OE5XRX/RemoteStation/index.md

---
---

# Amateurfunkclub für Remote Stationen

Diese Seite listet alle Schaltpläne, Platinen und BOMs des Projektes [Remote Station](https://github.com/OE5XRX/RemoteStation) des Vereines [Amateurfunkclub für Remote Stationen](https://oe5xrx.org).

## Bus PCB

<table>
  <tr><th>Top</th><th>Bottom</th></tr>
  <tr>
    <td>top</td>
    <td>bottom</td>
  </tr>
</table>

- [Schaltplan](pcb/bus/bus-schematic.pdf)
- [BOM](pcb/bus/bus-bom.html)
- [iBOM](pcb/bus/bus-ibom.html)
- [JLCPCB fabrication & stencil](pcb/bus/JLCPCB/bus-_JLCPCB_compress.zip)
- [JLCPCB Bom](pcb/bus/JLCPCB/bus_bom_jlc.csv)
- [JLCPCB Pic&Place](pcb/bus/JLCPCB/bus_cpl_jlc.csv)

## Power PCB

<table>
  <tr><th>Top</th><th>Bottom</th></tr>
  <tr>
    <td>top</td>
    <td>bottom</td>
  </tr>
</table>

- [Schaltplan](pcb/power/power-schematic.pdf)
- [BOM](pcb/power/power-bom.html)
- [iBOM](pcb/power/power-ibom.html)
- [JLCPCB fabrication & stencil](pcb/power/JLCPCB/power-_JLCPCB_compress.zip)
- [JLCPCB Bom](pcb/power/JLCPCB/power_bom_jlc.csv)
- [JLCPCB Pic&Place](pcb/power/JLCPCB/power_cpl_jlc.csv)

## CM4 PCB

<table>
  <tr><th>Top</th><th>Bottom</th></tr>
  <tr>
    <td>top</td>
    <td>bottom</td>
  </tr>
</table>

- [Schaltplan](pcb/cm4/cm4-schematic.pdf)
- [BOM](pcb/cm4/cm4-bom.html)
- [iBOM](pcb/cm4/cm4-ibom.html)
- [JLCPCB fabrication & stencil](pcb/cm4/JLCPCB/cm4-_JLCPCB_compress.zip)
- [JLCPCB Bom](pcb/cm4/JLCPCB/cm4_bom_jlc.csv)
- [JLCPCB Pic&Place](pcb/cm4/JLCPCB/cm4_cpl_jlc.csv)

Erstellt am {{ site.time | '%d.%m.%Y %H:%i:%s' }}, mit git hash: {{ site.data['hash'] }}.

**Wir lieben Open Source!**

Open_Source_Initiative
Open-source-hardware-logo
