OE5XRX/RemoteStation/docs/pcb/cm4.md

---
title: CM4 PCB
nav_order: 4
parent: Platinen
---

# CM4 PCB

<table>
  <tr><th>Top</th><th>Bottom</th></tr>
  <tr>
    <td>top</td>
    <td>bottom</td>
  </tr>
</table>

Das `CM4` Modul beherbergt das Gehirn der Remote Station: ein Computer Module 4 (CM4) von Raspberry Pi.
Das CM4 ist eine einfache Platine welche CPU, Speicher, Wifi und andere Komponenten direkt aufgelötet hat. Somit können über die zwei 100pin Stecker alle Schnittstellen direkt angesprochen werden.

**Verwendete Schnittstellen:**

| CM4 Schnittstelle | Anwendung |
| --- | --- |
| I<sup>2</sup>C | Messen der Versorgungsspannungen und Ströme |
| Ethernet | für die Verbindung zum Internet oder andere Netzwerke (Lan, externes Modem, etc.)  |
| SD-Card | für die Software (im Produktiven Betrieb soll das interne eMMC verwendet werden) |
| USB | zum aufspielen eines neuen Images in den eMMC oder zum ansprechen der Bus-Devices  |

Der benötigter Strom für das CM4 ist immer stark Abhängig welche Schnittstellen aktiv sind. Bei einem Raspberry Pi 4 kann dies bis zu 3A betragen. Nachdem jedoch kein HDMI vorgesehen ist wird sich der benötigter Strom auf unter 1A beschränken.

| Spannung | benötigter Strom |
| --- | --- |
| +5V | max. 1A |
| +12V | - |

## Daten

- [Schaltplan](cm4/cm4-schematic.pdf)
- [BOM](cm4/cm4-bom.html)
- [iBOM](cm4/cm4-ibom.html)
- [JLCPCB fabrication & stencil](cm4/JLCPCB/cm4-_JLCPCB_compress.zip)
- [JLCPCB Bom](cm4/JLCPCB/cm4_bom_jlc.csv)
- [JLCPCB Pick&Place](cm4/JLCPCB/cm4_cpl_jlc.csv)

## Gefundene Probleme in v0.1

- [X] Footprint von CM4 passt nicht (Outline muss vergrößert werden), CM4 Modul passt aber aktuell trotzdem drauf. Ausrichtung mit der Antenne beachten dann passt es
- [X] LED Schaltung kontrollieren
- [X] Debug UART (Serielle zur Console) auf Pinheader nach vorne
