OE5XRX/RemoteStation/docs/pcb/bus.md

---
title: Bus PCB
nav_order: 2
parent: Platinen
---

# Bus PCB

<table>
  <tr><th>Top</th><th>Bottom</th></tr>
  <tr>
    <td>top</td>
    <td>bottom</td>
  </tr>
</table>

Die `Bus` Platine verteilt die benötigten Versorgungsspannungen (+5V und +12V) zu allen Modulen. Weiters ist ein USB-Hub auf der Rückseite der Platine vorhanden um dem CM4-Modul Zugriff zu den Devices zu geben.
Die Platine welche die benötigten Versorgungsspannungen zur Verfügung stellt hat auch noch eine I<sup>2</sup>C Bus Verbindung zum CM4-Modul um die Spannungen und Ströme auslesen zu können.

| Spannung | benötigter Strom |
| --- | --- |
| +5V | 100mA |
| +12V | - |

## Daten

- [Schaltplan](bus/bus-schematic.pdf)
- [BOM](bus/bus-bom.html)
- [iBOM](bus/bus-ibom.html)
- [JLCPCB fabrication & stencil](bus/JLCPCB/bus-_JLCPCB_compress.zip)
- [JLCPCB Bom](bus/JLCPCB/bus_bom_jlc.csv)
- [JLCPCB Pick&Place](bus/JLCPCB/bus_cpl_jlc.csv)

## Gefundene Probleme in v0.1

- [X] USBLC6-2SC6 hat falschen Footprint, richtiger ist: SOT-23-6
