OE5XRX/RemoteStation/docs/pcb.md

---
title: Platinen
nav_order: 1
---

# Platinen

In den Unterseite findest du die Dokumentation der Platinen.
