OE5XRX/RemoteStation/pcb/fm/fm.kicad_pcb

## KiCad design pcb/fm/fm.kicad_pcb (2025-07-05)

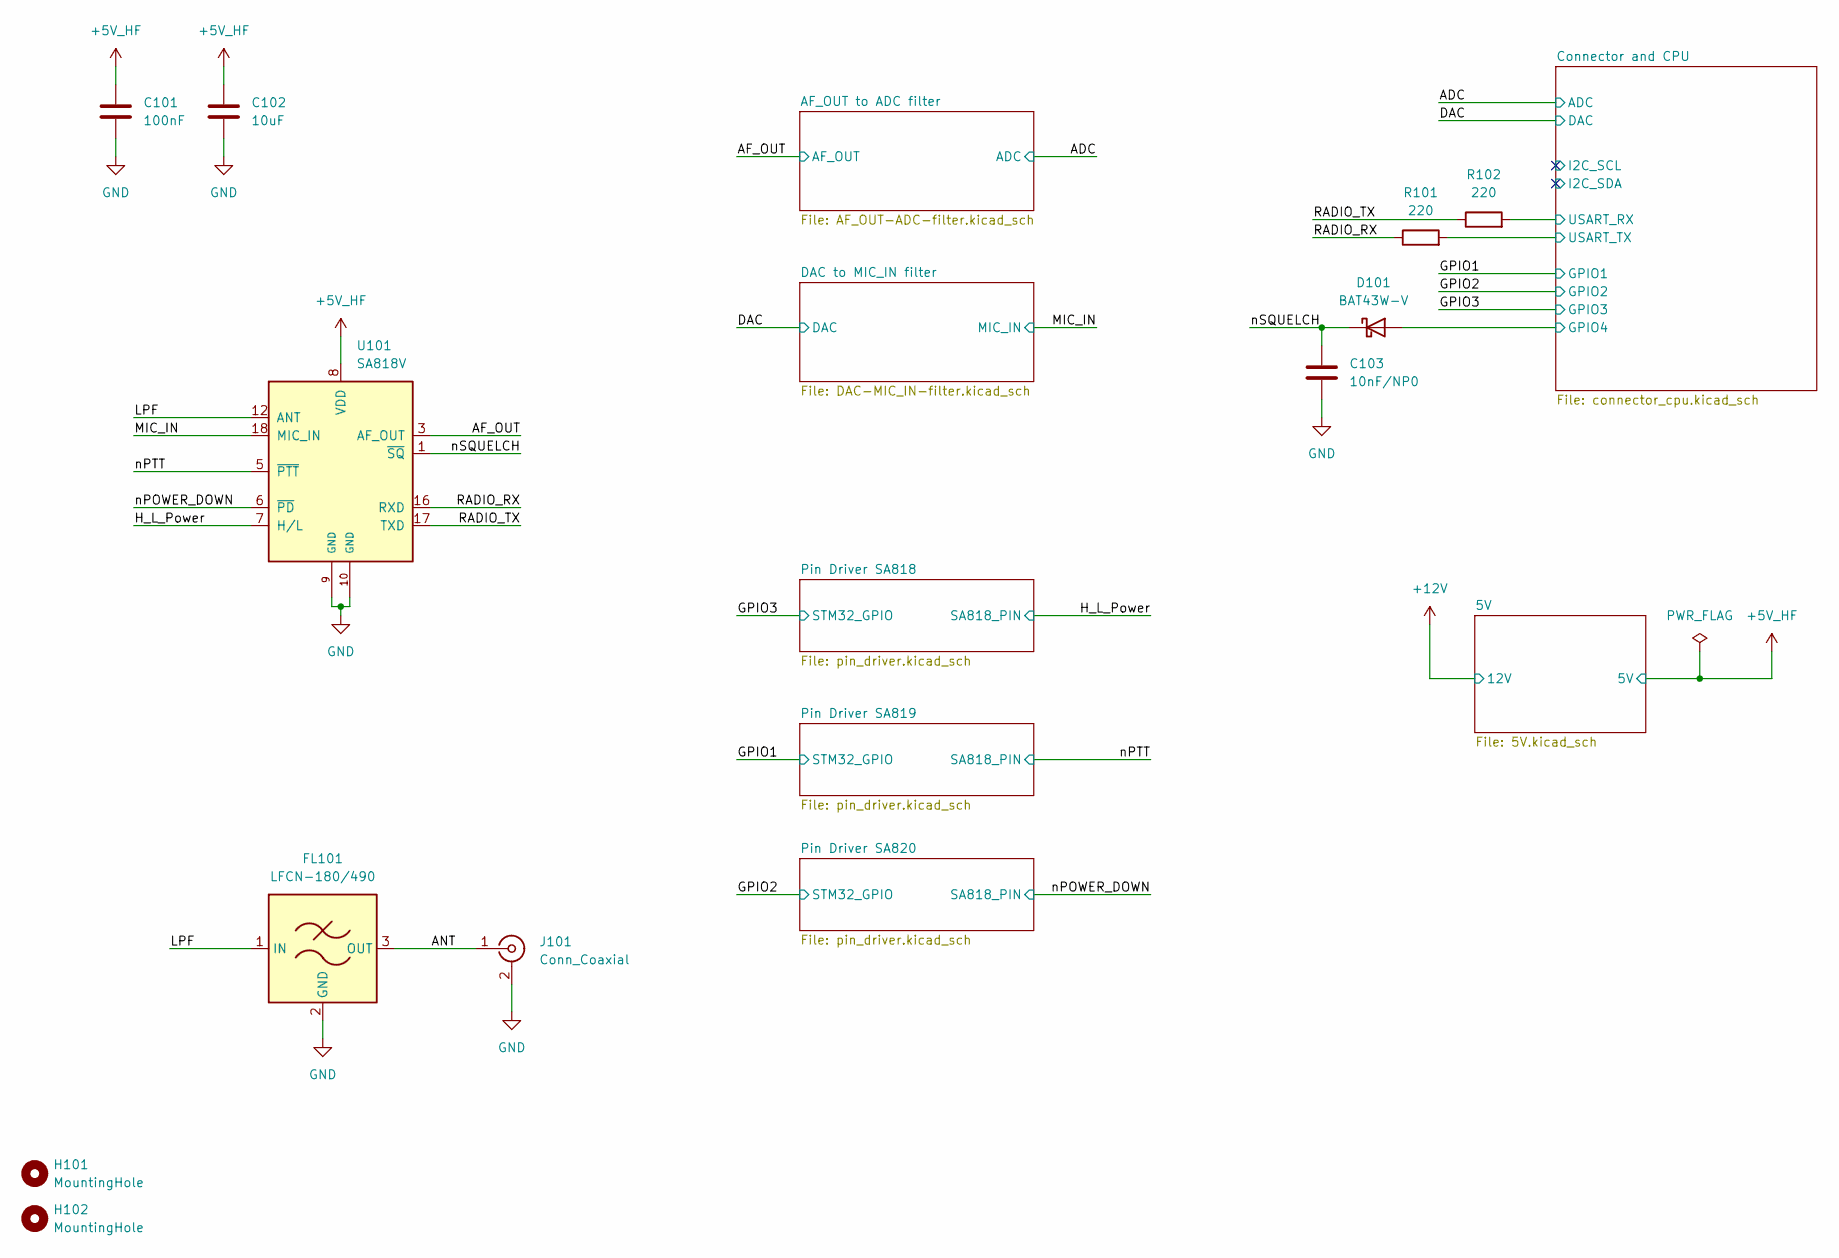
[picture p1: schematic fm.kicad_sch, FM Module]

Parts:
C101: 100nF; C_0805_2012Metric; LCSC C28233
C102: 10uF; C_0805_2012Metric; MOUSER 963-EMK212BJ106KG-T
C103: 10nF/NP0; C_0805_2012Metric; MOUSER 81-GRM2165C2A103JA1D
D101: BAT43W-V; D_SOD-123; MOUSER 78-BAT43W-G3-08
FL101: LFCN-180/490; Filter_Mini-Circuits_FV1206; MOUSER 139-LFCN-180,139-LFCN-490
H101, H102: MountingHole; MountingHole_3.2mm_M3
J101: Conn_Coaxial; SMA_Amphenol_132289_EdgeMount; MOUSER 530-142-0701-801
R101, R102: 220; R_0805_2012Metric; MOUSER 667-ERA-6AEB221V
U101: SA818V; DRA818; LCSC C3001504

Connections:
+5V_HF: C101.2, C102.2, U101.8 (VDD); also elsewhere on the board
/AF_OUT: U101.3 (AF_OUT); also elsewhere on the board
/ANT: FL101.3 (OUT), J101.1 (In)
/Connector and CPU/GPIO4: D101.2 (A); also elsewhere on the board
/Connector and CPU/USART_RX: R102.2; also elsewhere on the board
/Connector and CPU/USART_TX: R101.2; also elsewhere on the board
/H_L_Power: U101.7 (H/L); also elsewhere on the board
/LPF: FL101.1 (IN), U101.12 (ANT)
/MIC_IN: U101.18 (MIC_IN); also elsewhere on the board
/RADIO_RX: R101.1, U101.16 (RXD)
/RADIO_TX: R102.1, U101.17 (TXD)
/nPOWER_DOWN: U101.6 (~PD); also elsewhere on the board
/nPTT: U101.5 (~PTT); also elsewhere on the board
/nSQUELCH: C103.2, D101.1 (K), U101.1 (~SQ)
GND: C101.1, C102.1, C103.1, FL101.2 (GND), FL101.4 (GND), J101.2 (Ext), U101.9 (GND), U101.10 (GND); also elsewhere on the board

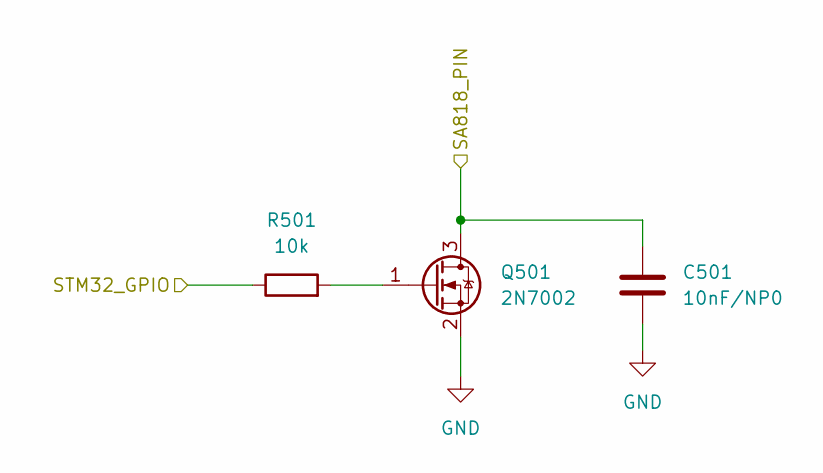
[picture p2: schematic pin_driver.kicad_sch, Pin Driver for the SA818]

Parts:
C501: 10nF/NP0; C_0805_2012Metric; MOUSER 81-GRM2165C2A103JA1D
Q501: 2N7002; SOT-23; MOUSER 637-2N7002
R501: 10k; R_0805_2012Metric; MOUSER 603-RT0805DRE0710KL

Connections:
/GPIO3: R501.1; also elsewhere on the board
/H_L_Power: C501.2, Q501.3 (D); also elsewhere on the board
GND: C501.1, Q501.2 (S); also elsewhere on the board
unnamed: Q501.1 (G), R501.2

Parts of its further copies:
C601, C701: 10nF/NP0; C_0805_2012Metric; MOUSER 81-GRM2165C2A103JA1D
Q601, Q701: 2N7002; SOT-23; MOUSER 637-2N7002
R601, R701: 10k; R_0805_2012Metric; MOUSER 603-RT0805DRE0710KL

Connections of its further copies:
/GPIO1: R601.1; also elsewhere on the board
/GPIO2: R701.1; also elsewhere on the board
/nPOWER_DOWN: C701.2, Q701.3 (D); also elsewhere on the board
/nPTT: C601.2, Q601.3 (D); also elsewhere on the board
GND: C601.1, C701.1, Q601.2 (S), Q701.2 (S); also elsewhere on the board
unnamed: Q601.1 (G), R601.2
unnamed: Q701.1 (G), R701.2

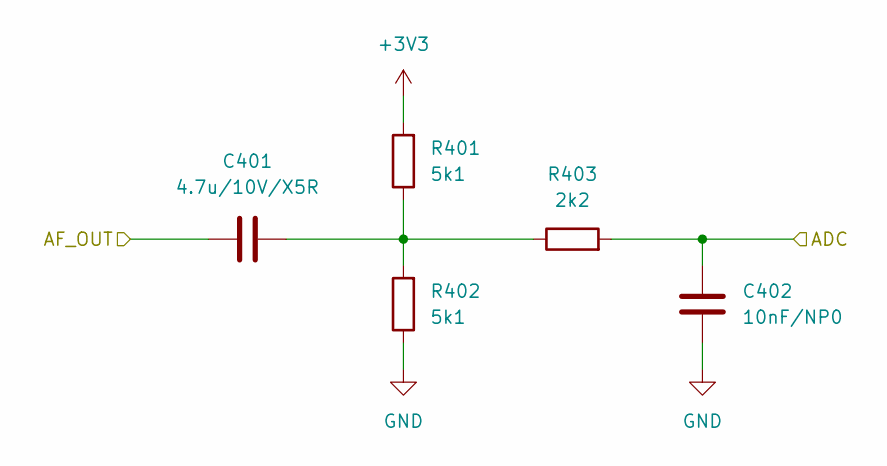
[picture p3: schematic AF_OUT-ADC-filter.kicad_sch, AF_OUT to ADC filter]

Parts:
C401: 4.7u/10V/X5R; C_0805_2012Metric; MOUSER 187-CL21A475KAQNNNF
C402: 10nF/NP0; C_0805_2012Metric; MOUSER 81-GRM2165C2A103JA1D
R401, R402: 5k1; R_0805_2012Metric; LCSC C27834
R403: 2k2; R_0805_2012Metric; LCSC C17520

Connections:
+3V3: R401.2; also elsewhere on the board
/ADC: C402.2, R403.2; also elsewhere on the board
/AF_OUT: C401.2; also elsewhere on the board
GND: C402.1, R402.1; also elsewhere on the board
unnamed: C401.1, R401.1, R402.2, R403.1

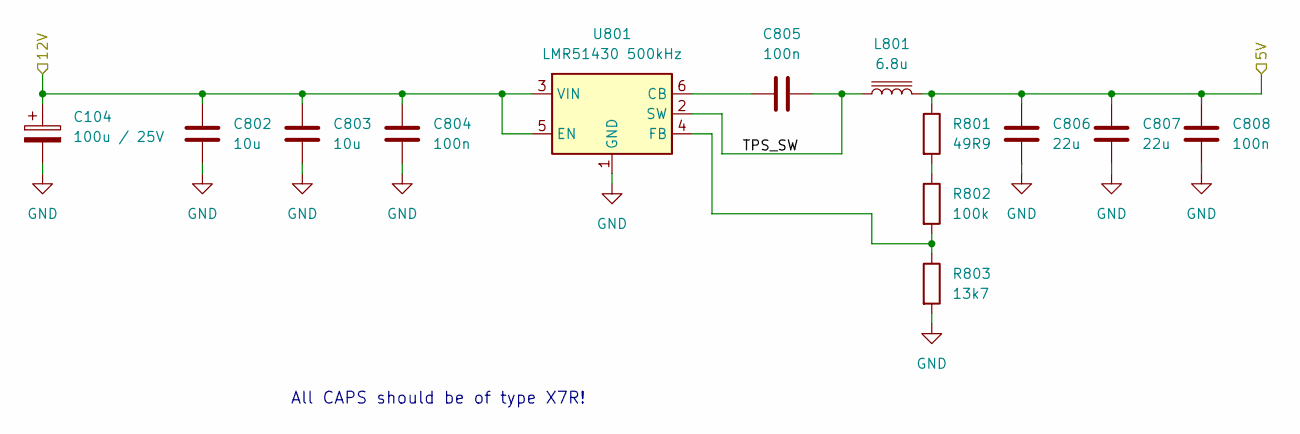
[picture p4: schematic 5V.kicad_sch, 5V HF]

Parts:
C104: 100u / 25V; CP_EIA-7343-43_Kemet-X; LCSC C132558
C802, C803: 10u; C_1206_3216Metric; LCSC C13585
C804, C805, C808: 100n; C_0805_2012Metric; LCSC C28233
C806, C807: 22u; C_1206_3216Metric; LCSC C12891
L801: 6.8u; WE-XHMI_6060; MOUSER 710-74439346068
R801: 49R9; R_0805_2012Metric; MOUSER 667-ERA-6AED49R9V
R802: 100k; R_0805_2012Metric; MOUSER 603-RC0805JR-07100KL
R803: 13k7; R_0805_2012Metric; MOUSER 652-CR0805FX-1372ELF
U801: LMR51430 500kHz; SOT-23-6; MOUSER 595-LMR51430XDDCR

Connections:
+5V_HF: C806.2, C807.2, C808.2, L801.2, R801.1; also elsewhere on the board
+12V: C104.1, C802.1, C803.1, C804.1, U801.3 (VIN), U801.5 (EN); also elsewhere on the board
/5V/TPS_SW: C805.2, L801.1, U801.2 (SW)
GND: C104.2, C802.2, C803.2, C804.2, C806.1, C807.1, C808.1, R803.2, U801.1 (GND); also elsewhere on the board
unnamed: R801.2, R802.1
unnamed: C805.1, U801.6 (CB)
unnamed: R802.2, R803.1, U801.4 (FB)

Notes on the sheet:
All CAPS should be of type X7R!

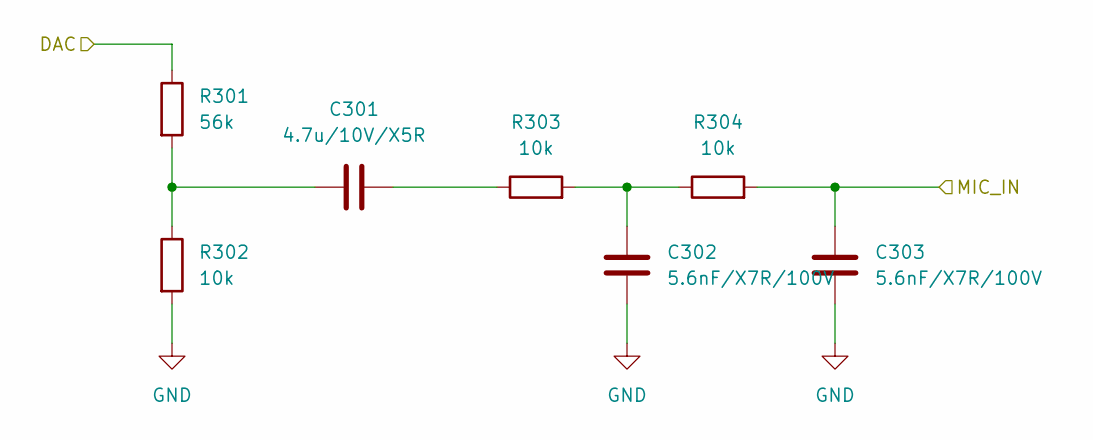
[picture p5: schematic DAC-MIC_IN-filter.kicad_sch, DAC to MIC_IN filter]

Parts:
C301: 4.7u/10V/X5R; C_0805_2012Metric; MOUSER 187-CL21A475KAQNNNF
C302, C303: 5.6nF/X7R/100V; C_0805_2012Metric; MOUSER 791-0805B562K201CT
R301: 56k; R_0805_2012Metric; MOUSER 603-RT0805DRE0756KL
R302, R303, R304: 10k; R_0805_2012Metric; MOUSER 603-RT0805DRE0710KL

Connections:
/DAC: R301.1; also elsewhere on the board
/MIC_IN: C303.1, R304.2; also elsewhere on the board
GND: C302.2, C303.2, R302.2; also elsewhere on the board
unnamed: C301.1, R303.1
unnamed: C301.2, R301.2, R302.1
unnamed: C302.1, R303.2, R304.1

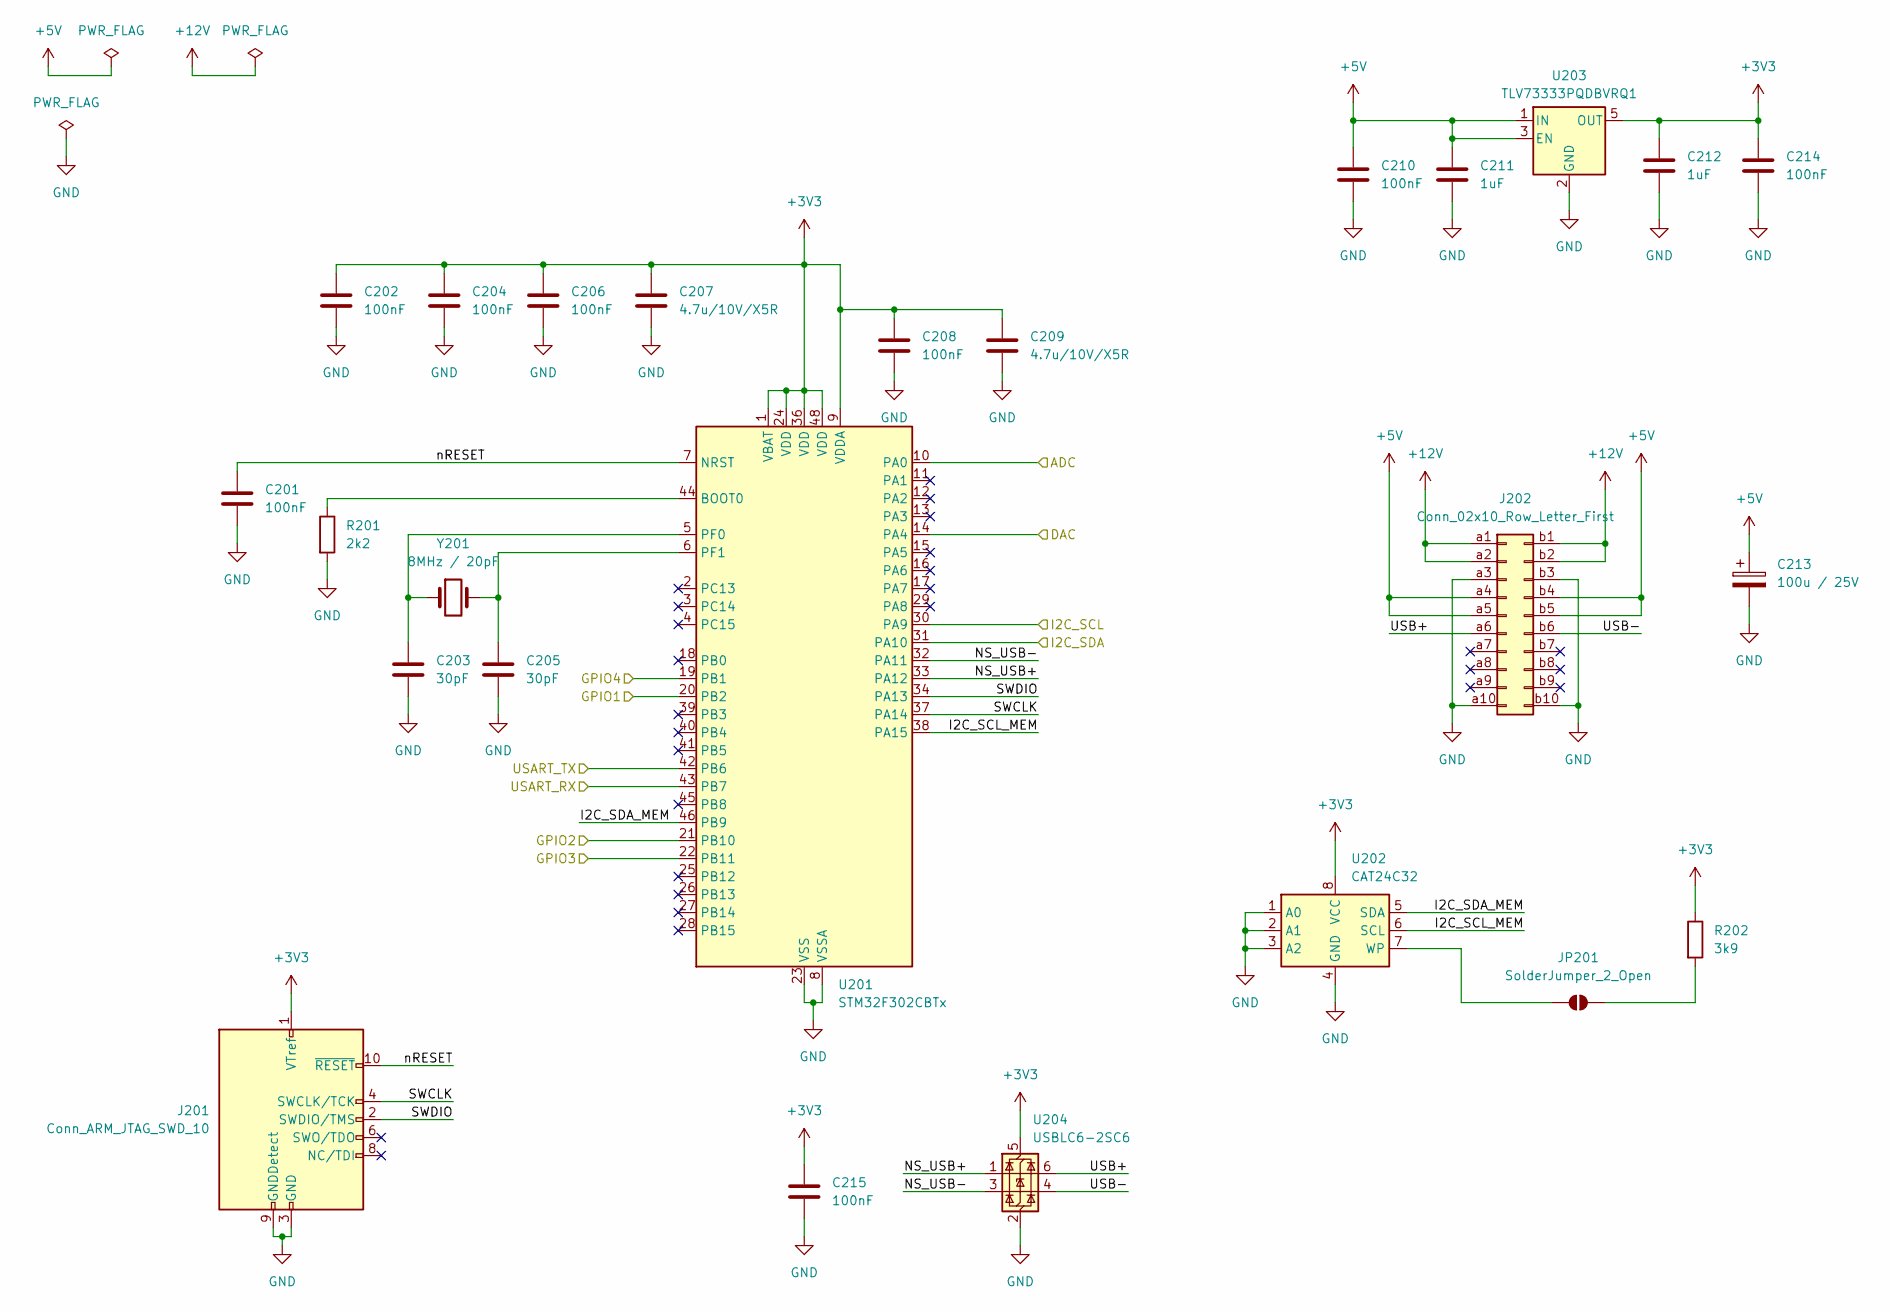
[picture p6: schematic connector_cpu.kicad_sch, STM32]

Parts:
C201, C202, C204, C206, C208, C210, C214, C215: 100nF; C_0805_2012Metric; LCSC C28233
C203, C205: 30pF; C_0805_2012Metric; MOUSER 791-0805N300J500CT
C207, C209: 4.7u/10V/X5R; C_0805_2012Metric; MOUSER 187-CL21A475KAQNNNF
C211, C212: 1uF; C_0805_2012Metric; MOUSER 791-0805B105K250CT
C213: 100u / 25V; CP_EIA-7343-43_Kemet-X; LCSC C132558
J201: Conn_ARM_JTAG_SWD_10; PinHeader_2x05_P2.54mm_Horizontal
J202: Conn_02x10_Row_Letter_First; PCN10C-20S-2.54DS; MOUSER 798-PCN10C20S254DS72
JP201: SolderJumper_2_Open; SolderJumper-2_P1.3mm_Open_RoundedPad1.0x1.5mm
R201: 2k2; R_0805_2012Metric; LCSC C17520
R202: 3k9; R_0805_2012Metric; MOUSER 603-RT0805DRD073K9L
U201: STM32F302CBTx; LQFP-48_7x7mm_P0.5mm; MOUSER 511-STM32F302CBT7
U202: CAT24C32; SOIC-8_3.9x4.9mm_P1.27mm; MOUSER 698-CAT24C32WI-GT3
U203: TLV73333PQDBVRQ1; SOT-23-5; LCSC C2862550
U204: USBLC6-2SC6; SOT-23-6; LCSC C2827654
Y201: 8MHz / 20pF; Crystal_SMD_HC49-SD; MOUSER 73-XT49M800-20

Connections:
+3V3: C202.2, C204.2, C206.2, C207.2, C208.2, C209.2, C212.1, C214.2, C215.1, J201.1 (VTref), R202.1, U201.1 (VBAT), U201.9 (VDDA), U201.24 (VDD), U201.36 (VDD), U201.48 (VDD), U202.8 (VCC), U203.5 (OUT), U204.5 (VBUS); also elsewhere on the board
+5V: C210.2, C211.1, C213.1, J202.a4, J202.a5, J202.b4, J202.b5, U203.1 (IN), U203.3 (EN)
+12V: J202.a1, J202.a2, J202.b1, J202.b2; also elsewhere on the board
/ADC: U201.10 (PA0); also elsewhere on the board
/Connector and CPU/GPIO4: U201.19 (PB1); also elsewhere on the board
/Connector and CPU/I2C_SCL: U201.30 (PA9)
/Connector and CPU/I2C_SCL_MEM: U201.38 (PA15), U202.6 (SCL)
/Connector and CPU/I2C_SDA: U201.31 (PA10)
/Connector and CPU/I2C_SDA_MEM: U201.46 (PB9), U202.5 (SDA)
/Connector and CPU/NS_USB+: U201.33 (PA12), U204.1 (I/O1)
/Connector and CPU/NS_USB-: U201.32 (PA11), U204.3 (I/O2)
/Connector and CPU/SWCLK: J201.4 (SWCLK/TCK), U201.37 (PA14)
/Connector and CPU/SWDIO: J201.2 (SWDIO/TMS), U201.34 (PA13)
/Connector and CPU/USART_RX: U201.43 (PB7); also elsewhere on the board
/Connector and CPU/USART_TX: U201.42 (PB6); also elsewhere on the board
/Connector and CPU/USB+: J202.a6, U204.6 (I/O1)
/Connector and CPU/USB-: J202.b6, U204.4 (I/O2)
/Connector and CPU/nRESET: C201.1, J201.10 (~RESET), U201.7 (NRST)
/DAC: U201.14 (PA4); also elsewhere on the board
/GPIO1: U201.20 (PB2); also elsewhere on the board
/GPIO2: U201.21 (PB10); also elsewhere on the board
/GPIO3: U201.22 (PB11); also elsewhere on the board
GND: C201.2, C202.1, C203.2, C204.1, C205.2, C206.1, C207.1, C208.1, C209.1, C210.1, C211.2, C212.2, C213.2, C214.1, C215.2, J201.3 (GND), J201.5 (GND), J201.9 (GNDDetect), J202.a3, J202.a10, J202.b3, J202.b10, R201.2, U201.8 (VSSA), U201.23 (VSS), U201.35 (VSS), U201.47 (VSS), U202.1 (A0), U202.2 (A1), U202.3 (A2), U202.4 (GND), U203.2 (GND), U204.2 (GND); also elsewhere on the board
unnamed: JP201.1 (A), U202.7 (WP)
unnamed: JP201.2 (B), R202.2
unnamed: R201.1, U201.44 (BOOT0)
unnamed: C203.1, U201.5 (PF0), Y201.1
unnamed: C205.1, U201.6 (PF1), Y201.2

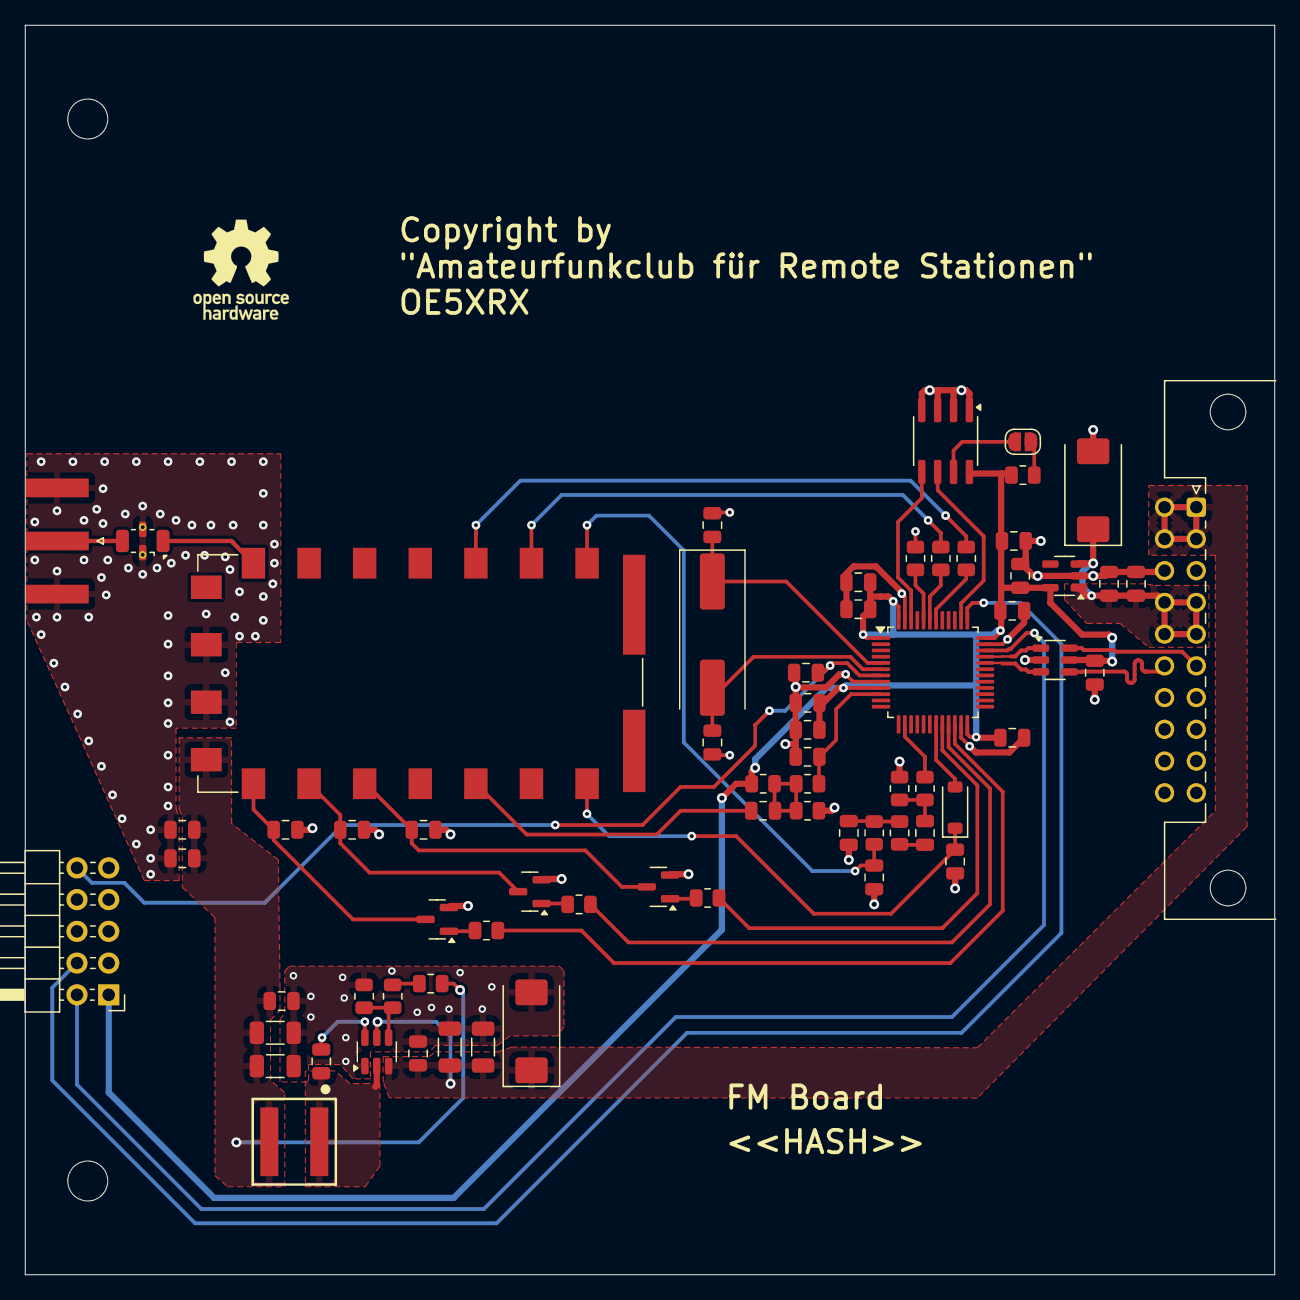
[picture p7: board fm.kicad_pcb from above]

Board: 4 copper layers, 100.0 x 100.0 mm, 70 parts (0 on the bottom side), 48 nets.
