OE5XRX/RemoteStation/pcb/bus/bus.kicad_pcb

## KiCad design pcb/bus/bus.kicad_pcb (2025-07-01)

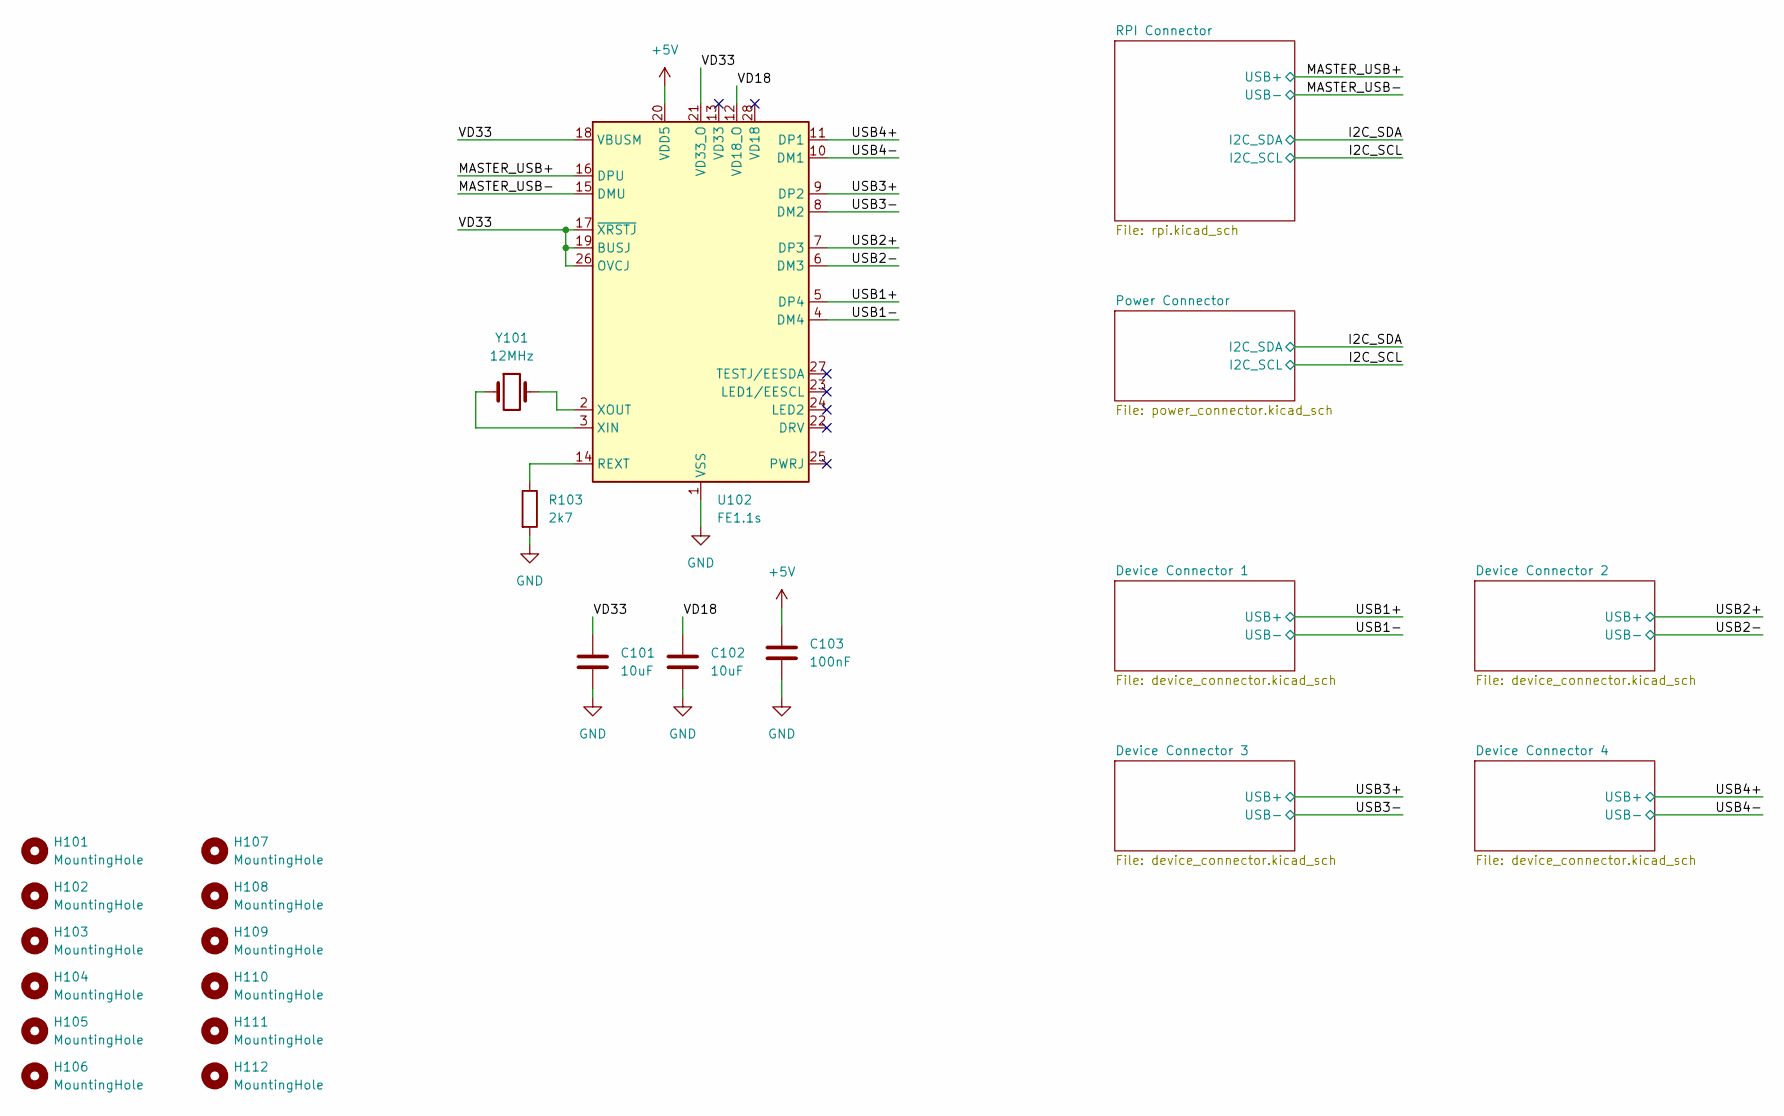
[picture p8: schematic bus.kicad_sch, Bus, USB]

Parts:
C101, C102: 10uF; C_0805_2012Metric; LCSC C13585
C103: 100nF; C_0805_2012Metric; LCSC C28233
H101, H102, H103, H104, H105, H106, H107, H108, H109, H110, H111, H112: MountingHole; MountingHole_3.2mm_M3
R103: 2k7; R_0805_2012Metric; LCSC C352230
U102: FE1.1s; SSOP-28_3.9x9.9mm_P0.635mm; LCSC C6706491
Y101: 12MHz; M49S-SMD; LCSC C2983432

Connections:
+5V: C103.1, U102.20 (VDD5); also elsewhere on the board
/MASTER_USB+: U102.16 (DPU); also elsewhere on the board
/MASTER_USB-: U102.15 (DMU); also elsewhere on the board
/USB1+: U102.5 (DP4); also elsewhere on the board
/USB1-: U102.4 (DM4); also elsewhere on the board
/USB2+: U102.7 (DP3); also elsewhere on the board
/USB2-: U102.6 (DM3); also elsewhere on the board
/USB3+: U102.9 (DP2); also elsewhere on the board
/USB3-: U102.8 (DM2); also elsewhere on the board
/USB4+: U102.11 (DP1); also elsewhere on the board
/USB4-: U102.10 (DM1); also elsewhere on the board
/VD18: C102.1, U102.12 (VD18_O)
/VD33: C101.1, U102.17 (~XRSTJ), U102.18 (VBUSM), U102.19 (BUSJ), U102.21 (VD33_O), U102.26 (OVCJ)
GND: C101.2, C102.2, C103.2, R103.2, U102.1 (VSS); also elsewhere on the board
unnamed: R103.1, U102.14 (REXT)
unnamed: U102.3 (XIN), Y101.1
unnamed: U102.2 (XOUT), Y101.2

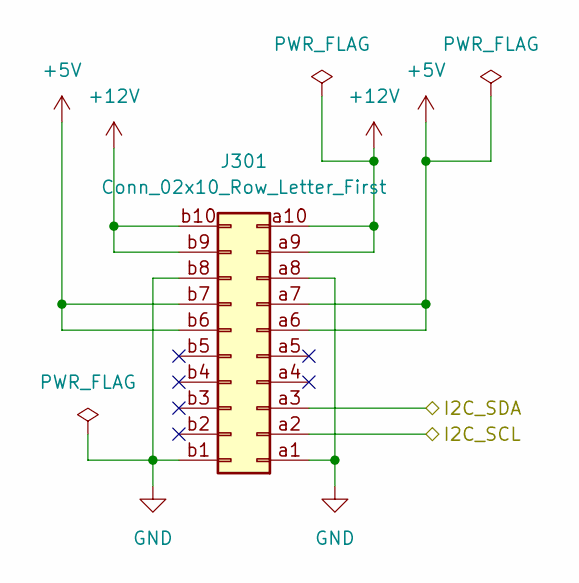
[picture p9: schematic power_connector.kicad_sch]

Parts:
J301: Conn_02x10_Row_Letter_First; PCN10-20P-2.54DSA; MOUSER 798-PCN1020P254DSA72

Connections:
+5V: J301.a6, J301.a7, J301.b6, J301.b7; also elsewhere on the board
+12V: J301.a9, J301.a10, J301.b9, J301.b10; also elsewhere on the board
/I2C_SCL: J301.a2; also elsewhere on the board
/I2C_SDA: J301.a3; also elsewhere on the board
GND: J301.a1, J301.a8, J301.b1, J301.b8; also elsewhere on the board

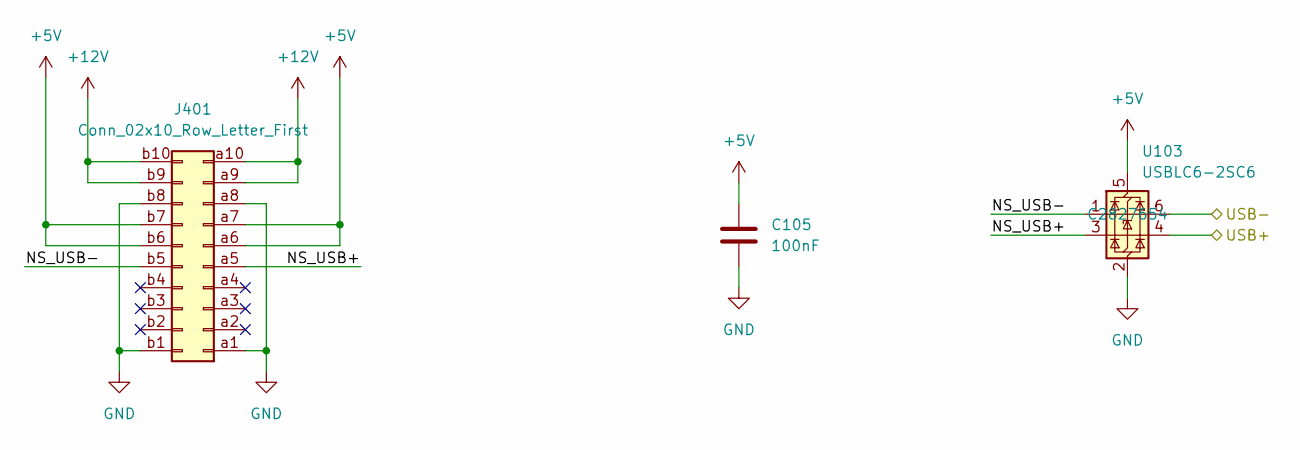
[picture p10: schematic device_connector.kicad_sch]

Parts:
C105: 100nF; C_0805_2012Metric; LCSC C28233
J401: Conn_02x10_Row_Letter_First; PCN10-20P-2.54DSA; MOUSER 798-PCN1020P254DSA72
U103: USBLC6-2SC6; SOT-23-6; LCSC C2827654

Connections:
+5V: C105.1, J401.a6, J401.a7, J401.b6, J401.b7, U103.5 (VBUS); also elsewhere on the board
+12V: J401.a9, J401.a10, J401.b9, J401.b10; also elsewhere on the board
/Device Connector 1/NS_USB+: J401.a5, U103.3 (I/O2)
/Device Connector 1/NS_USB-: J401.b5, U103.1 (I/O1)
/USB1+: U103.4 (I/O2); also elsewhere on the board
/USB1-: U103.6 (I/O1); also elsewhere on the board
GND: C105.2, J401.a1, J401.a8, J401.b1, J401.b8, U103.2 (GND); also elsewhere on the board

Parts of its further copies:
C106, C107, C108: 100nF; C_0805_2012Metric; LCSC C28233
J501, J601, J701: Conn_02x10_Row_Letter_First; PCN10-20P-2.54DSA; MOUSER 798-PCN1020P254DSA72
U104, U105, U106: USBLC6-2SC6; SOT-23-6; LCSC C2827654

Connections of its further copies:
+5V: C106.1, C107.1, C108.1, J501.a6, J501.a7, J501.b6, J501.b7, J601.a6, J601.a7, J601.b6, J601.b7, J701.a6, J701.a7, J701.b6, J701.b7, U104.5 (VBUS), U105.5 (VBUS), U106.5 (VBUS); also elsewhere on the board
+12V: J501.a9, J501.a10, J501.b9, J501.b10, J601.a9, J601.a10, J601.b9, J601.b10, J701.a9, J701.a10, J701.b9, J701.b10; also elsewhere on the board
/Device Connector 2/NS_USB+: J501.a5, U104.3 (I/O2)
/Device Connector 2/NS_USB-: J501.b5, U104.1 (I/O1)
/Device Connector 3/NS_USB+: J601.a5, U105.3 (I/O2)
/Device Connector 3/NS_USB-: J601.b5, U105.1 (I/O1)
/Device Connector 4/NS_USB+: J701.a5, U106.3 (I/O2)
/Device Connector 4/NS_USB-: J701.b5, U106.1 (I/O1)
/USB2+: U104.4 (I/O2); also elsewhere on the board
/USB2-: U104.6 (I/O1); also elsewhere on the board
/USB3+: U105.4 (I/O2); also elsewhere on the board
/USB3-: U105.6 (I/O1); also elsewhere on the board
/USB4+: U106.4 (I/O2); also elsewhere on the board
/USB4-: U106.6 (I/O1); also elsewhere on the board
GND: C106.2, C107.2, C108.2, J501.a1, J501.a8, J501.b1, J501.b8, J601.a1, J601.a8, J601.b1, J601.b8, J701.a1, J701.a8, J701.b1, J701.b8, U104.2 (GND), U105.2 (GND), U106.2 (GND); also elsewhere on the board

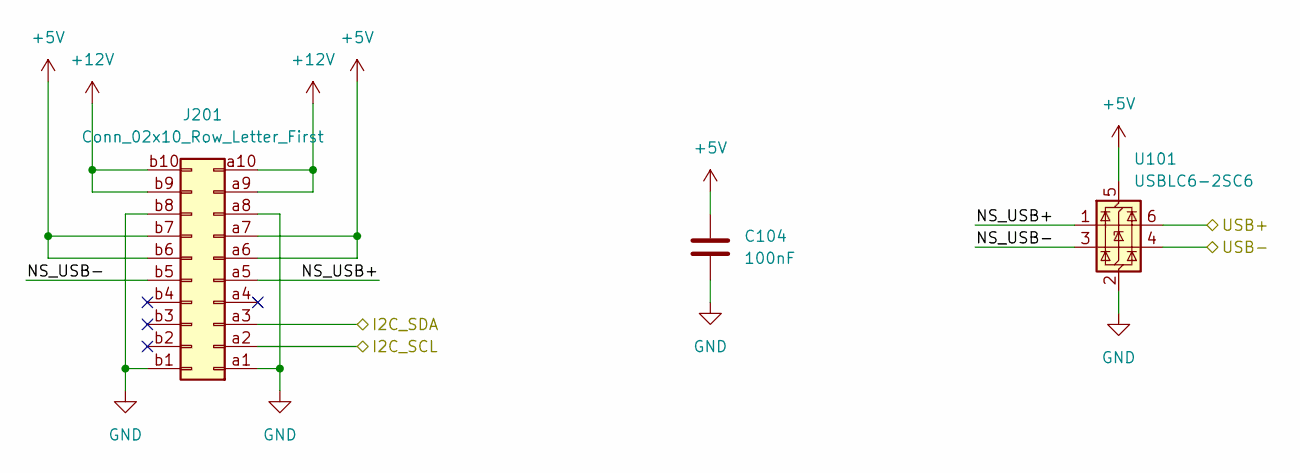
[picture p11: schematic rpi.kicad_sch, Bus Connector]

Parts:
C104: 100nF; C_0805_2012Metric; LCSC C28233
J201: Conn_02x10_Row_Letter_First; PCN10-20P-2.54DSA; MOUSER 798-PCN1020P254DSA72
U101: USBLC6-2SC6; SOT-23-6; LCSC C2827654

Connections:
+5V: C104.1, J201.a6, J201.a7, J201.b6, J201.b7, U101.5 (VBUS); also elsewhere on the board
+12V: J201.a9, J201.a10, J201.b9, J201.b10; also elsewhere on the board
/I2C_SCL: J201.a2; also elsewhere on the board
/I2C_SDA: J201.a3; also elsewhere on the board
/MASTER_USB+: U101.6 (I/O1); also elsewhere on the board
/MASTER_USB-: U101.4 (I/O2); also elsewhere on the board
/RPI Connector/NS_USB+: J201.a5, U101.1 (I/O1)
/RPI Connector/NS_USB-: J201.b5, U101.3 (I/O2)
GND: C104.2, J201.a1, J201.a8, J201.b1, J201.b8, U101.2 (GND); also elsewhere on the board

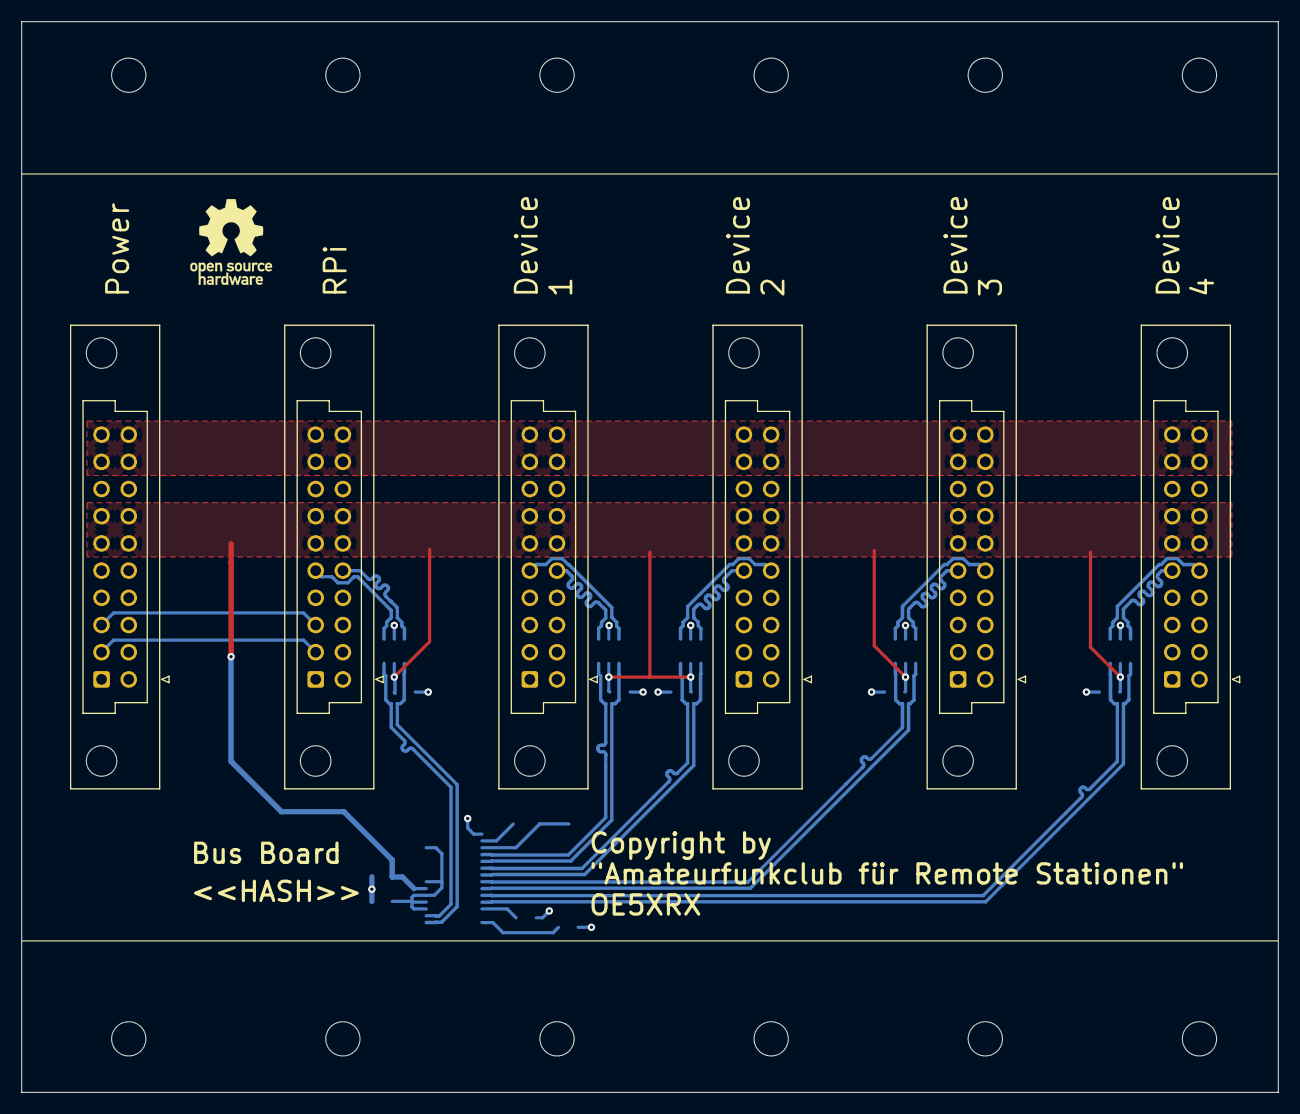
[picture p12: board bus.kicad_pcb from above]

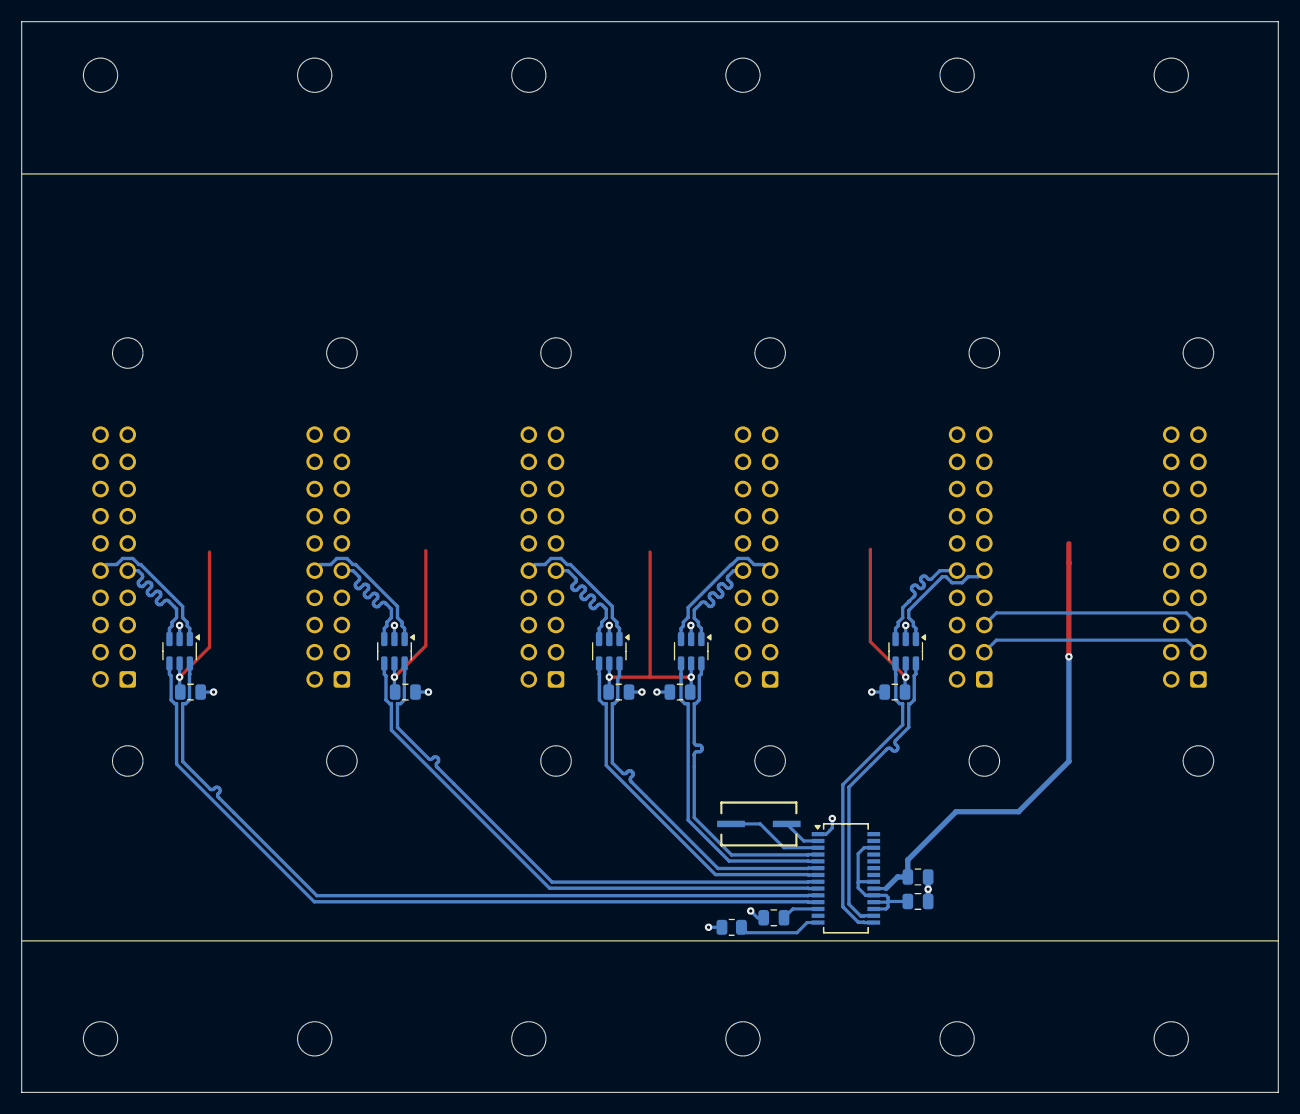
[picture p13: board bus.kicad_pcb from below]

Board: 4 copper layers, 117.4 x 100.0 mm, 34 parts (16 on the bottom side), 30 nets.
