OE5XRX/RemoteStation/pcb/device_test/device_test.kicad_pcb

## KiCad design pcb/device_test/device_test.kicad_pcb (2025-05-25)

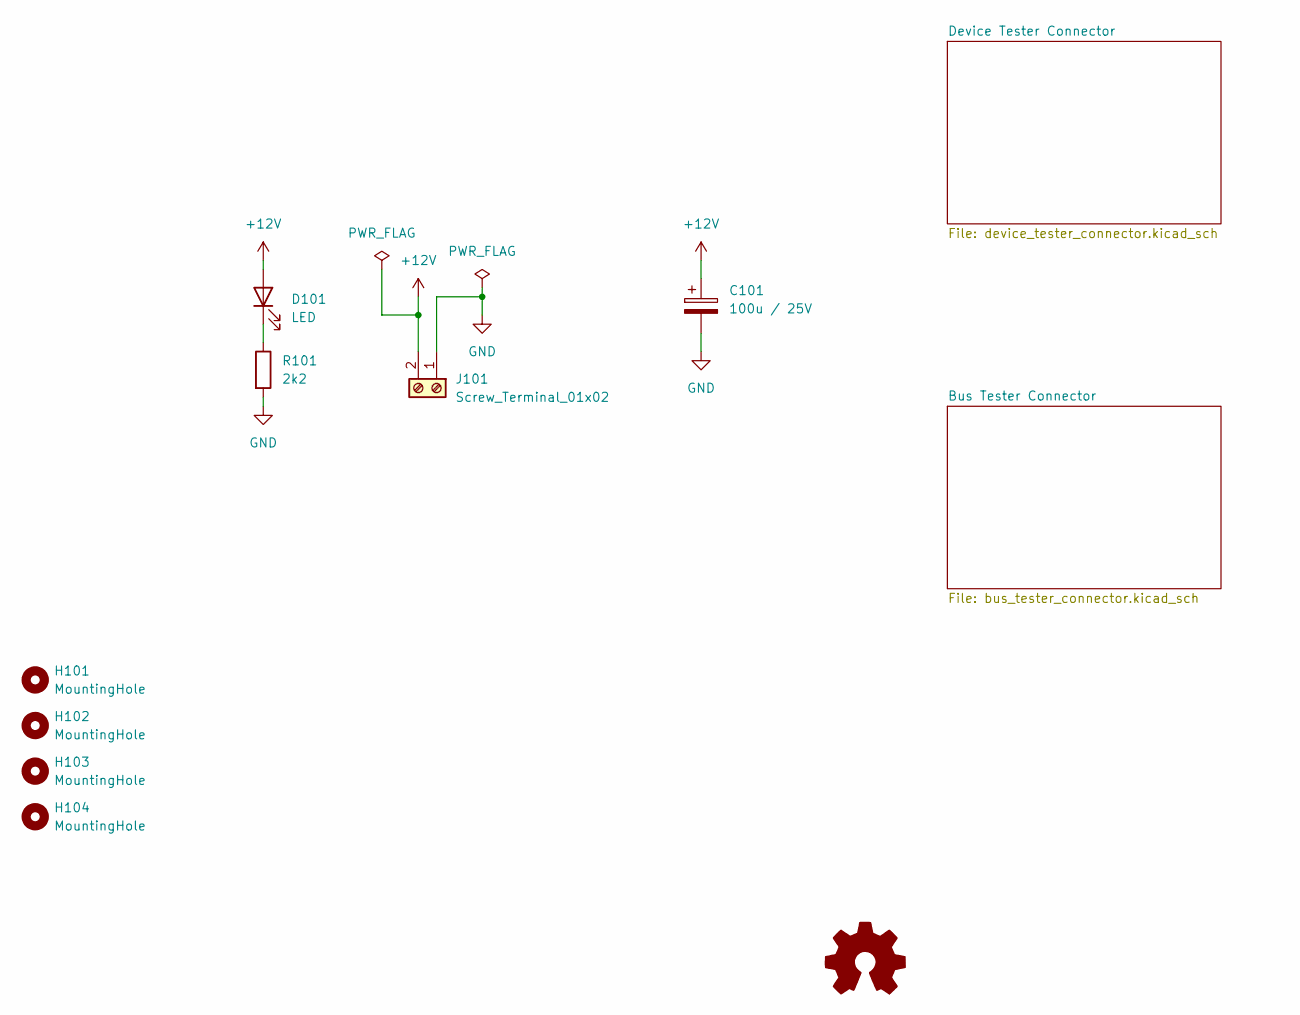
[picture p14: schematic device_test.kicad_sch, Device Tester]

Parts:
C101: 100u / 25V; CP_EIA-7343-43_Kemet-X; LCSC C132558
D101: LED; LED_0805_2012Metric; LCSC C84256
H101, H102, H103, H104: MountingHole; MountingHole_3.2mm_M3
J101: Screw_Terminal_01x02; TerminalBlock_Phoenix_MKDS-1,5-2-5.08_1x02_P5.08mm_Horizont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; LCSC C5349557
R101: 2k2; R_0805_2012Metric; LCSC C17520

Connections:
+12V: C101.1, D101.2 (A), J101.2; also elsewhere on the board
GND: C101.2, J101.1, R101.2; also elsewhere on the board
unnamed: D101.1 (K), R101.1

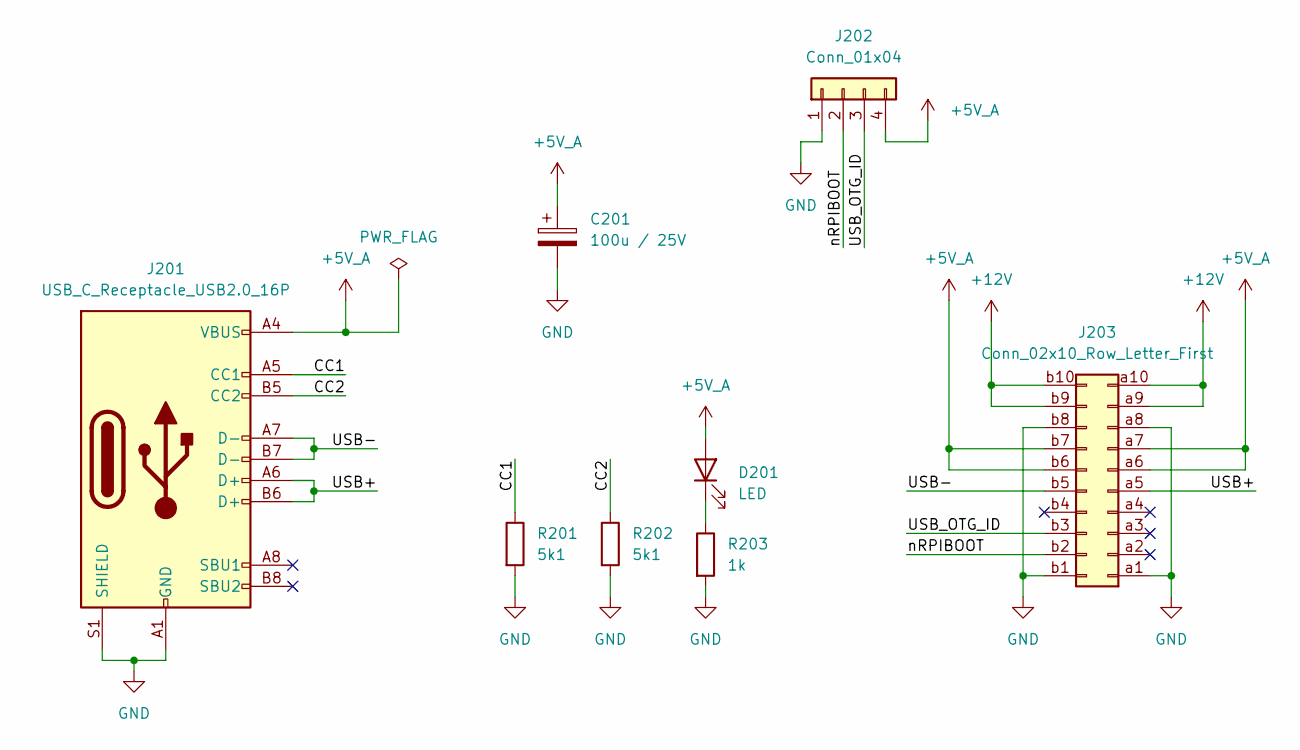
[picture p15: schematic device_tester_connector.kicad_sch, Device Tester Connector]

Parts:
C201: 100u / 25V; CP_EIA-7343-43_Kemet-X; LCSC C132558
D201: LED; LED_0805_2012Metric; LCSC C84256
J201: USB_C_Receptacle_USB2.0_16P; USB_C_Receptacle_G-Switch_GT-USB-7010ASV; LCSC C2988369
J202: Conn_01x04; PinHeader_1x04_P2.54mm_Vertical; LCSC C2691448
J203: Conn_02x10_Row_Letter_First; PCN10-20P-2.54DS; MOUSER 798-PCN1020P254DS72
R201, R202: 5k1; R_0805_2012Metric; LCSC C27834
R203: 1k; R_0805_2012Metric; LCSC C17513

Connections:
+5V_A: C201.1, D201.2 (A), J201.A4 (VBUS), J201.A9 (VBUS), J201.B4 (VBUS), J201.B9 (VBUS), J202.4, J203.a6, J203.a7, J203.b6, J203.b7
+12V: J203.a9, J203.a10, J203.b9, J203.b10; also elsewhere on the board
/Device Tester Connector/CC1: J201.A5 (CC1), R201.1
/Device Tester Connector/CC2: J201.B5 (CC2), R202.1
/Device Tester Connector/USB+: J201.A6 (D+), J201.B6 (D+), J203.a5
/Device Tester Connector/USB-: J201.A7 (D-), J201.B7 (D-), J203.b5
/Device Tester Connector/USB_OTG_ID: J202.3, J203.b3
/Device Tester Connector/nRPIBOOT: J202.2, J203.b2
GND: C201.2, J201.A1 (GND), J201.A12 (GND), J201.B1 (GND), J201.B12 (GND), J201.S1 (SHIELD), J202.1, J203.a1, J203.a8, J203.b1, J203.b8, R201.2, R202.2, R203.2; also elsewhere on the board
unnamed: D201.1 (K), R203.1

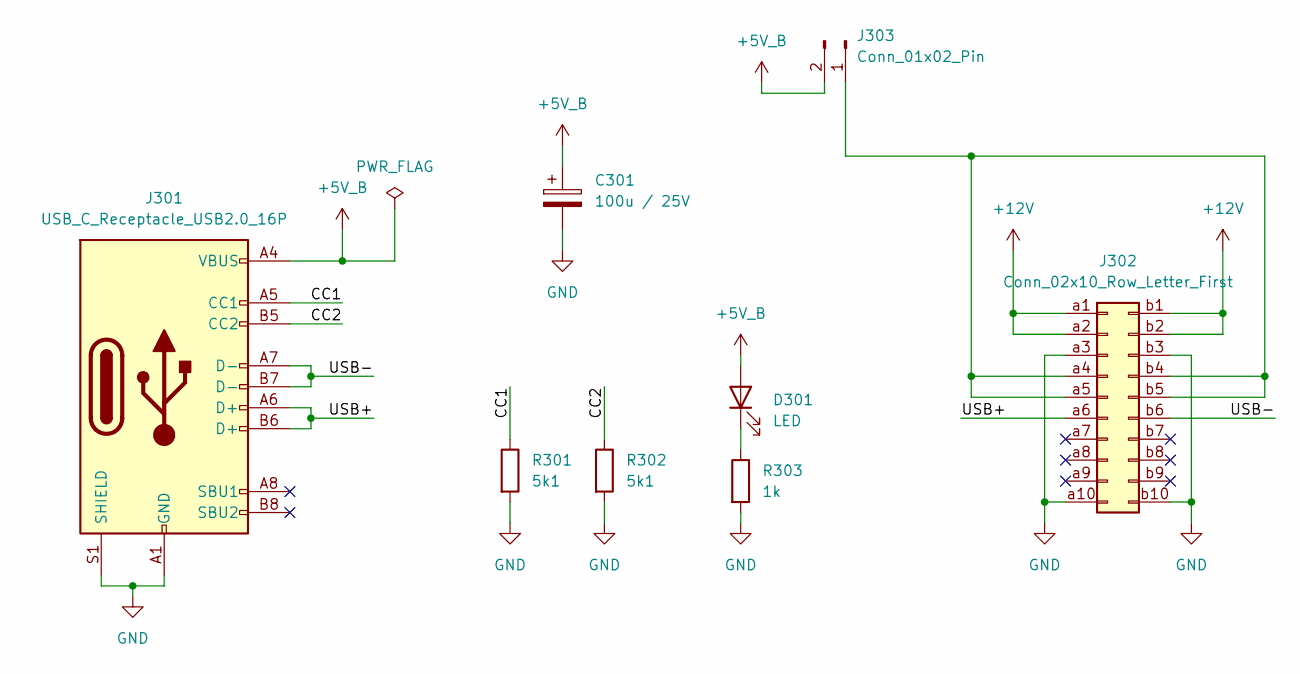
[picture p16: schematic bus_tester_connector.kicad_sch, Device Tester Connector]

Parts:
C301: 100u / 25V; CP_EIA-7343-43_Kemet-X; LCSC C132558
D301: LED; LED_0805_2012Metric; LCSC C84256
J301: USB_C_Receptacle_USB2.0_16P; USB_C_Receptacle_G-Switch_GT-USB-7010ASV; LCSC C2988369
J302: Conn_02x10_Row_Letter_First; PCN10C-20S-2.54DS; MOUSER 798-PCN10C20S254DS72
J303: Conn_01x02_Pin; PinHeader_1x02_P2.54mm_Vertical
R301, R302: 5k1; R_0805_2012Metric; LCSC C27834
R303: 1k; R_0805_2012Metric; LCSC C17513

Connections:
+5V_B: C301.1, D301.2 (A), J301.A4 (VBUS), J301.A9 (VBUS), J301.B4 (VBUS), J301.B9 (VBUS), J303.2
+12V: J302.a1, J302.a2, J302.b1, J302.b2; also elsewhere on the board
/Bus Tester Connector/CC1: J301.A5 (CC1), R301.1
/Bus Tester Connector/CC2: J301.B5 (CC2), R302.1
/Bus Tester Connector/USB+: J301.A6 (D+), J301.B6 (D+), J302.a6
/Bus Tester Connector/USB-: J301.A7 (D-), J301.B7 (D-), J302.b6
GND: C301.2, J301.A1 (GND), J301.A12 (GND), J301.B1 (GND), J301.B12 (GND), J301.S1 (SHIELD), J302.a3, J302.a10, J302.b3, J302.b10, R301.2, R302.2, R303.2; also elsewhere on the board
unnamed: D301.1 (K), R303.1
unnamed: J302.a4, J302.a5, J302.b4, J302.b5, J303.1

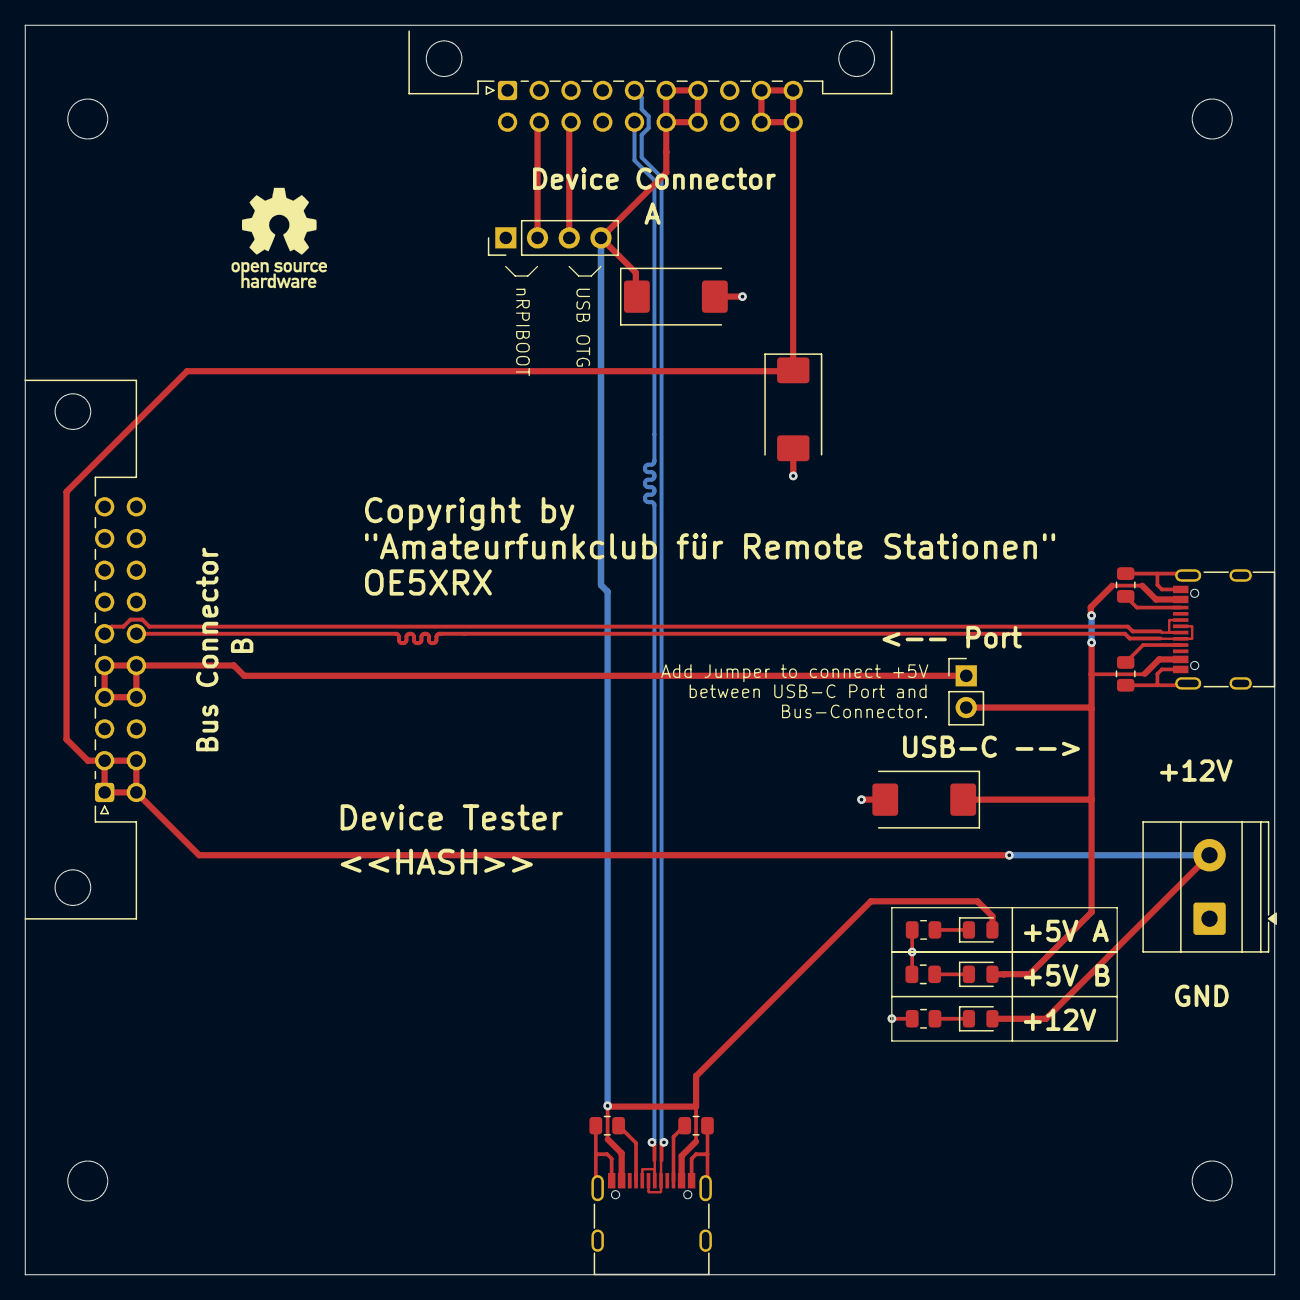
[picture p17: board device_test.kicad_pcb from above]

Board: 4 copper layers, 100.0 x 100.0 mm, 24 parts (0 on the bottom side), 18 nets.
