OE5XRX/RemoteStation/pcb/cm4/cm4.kicad_pcb

## KiCad design pcb/cm4/cm4.kicad_pcb (2025-05-25)

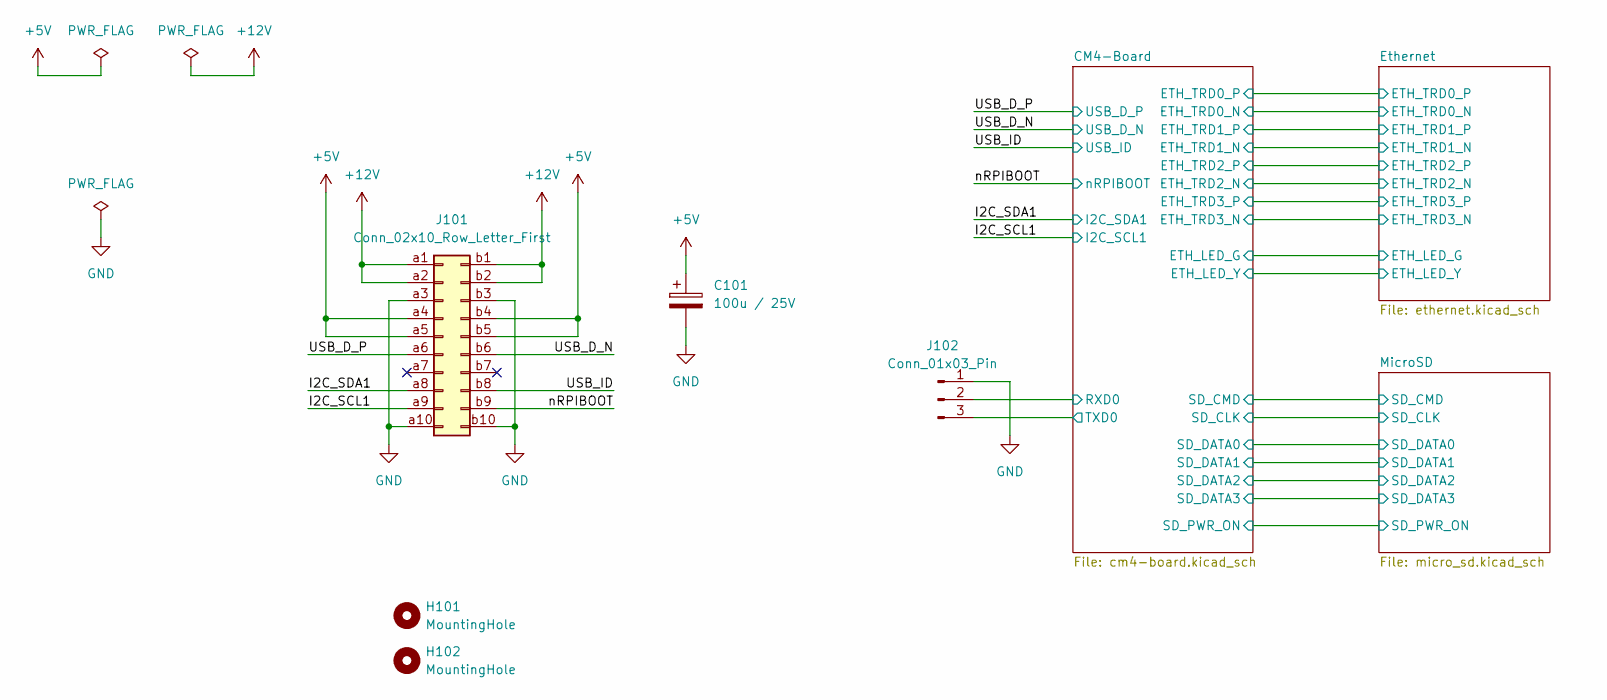
[picture p18: schematic cm4.kicad_sch, Bus Connector]

Parts:
C101: 100u / 25V; CP_EIA-7343-43_Kemet-X; LCSC C132558
H101, H102: MountingHole; MountingHole_3.2mm_M3
J101: Conn_02x10_Row_Letter_First; PCN10C-20S-2.54DS; MOUSER 798-PCN10C20S254DS72
J102: Conn_01x03_Pin; PinHeader_1x03_P2.54mm_Horizontal

Connections:
+5V: C101.1, J101.a4, J101.a5, J101.b4, J101.b5; also elsewhere on the board
+12V: J101.a1, J101.a2, J101.b1, J101.b2
/CM4-Board/RXD0: J102.2; also elsewhere on the board
/CM4-Board/TXD0: J102.3; also elsewhere on the board
/I2C_SCL1: J101.a9; also elsewhere on the board
/I2C_SDA1: J101.a8; also elsewhere on the board
/USB_D_N: J101.b6; also elsewhere on the board
/USB_D_P: J101.a6; also elsewhere on the board
/USB_ID: J101.b8; also elsewhere on the board
/nRPIBOOT: J101.b9; also elsewhere on the board
GND: C101.2, J101.a3, J101.a10, J101.b3, J101.b10, J102.1; also elsewhere on the board

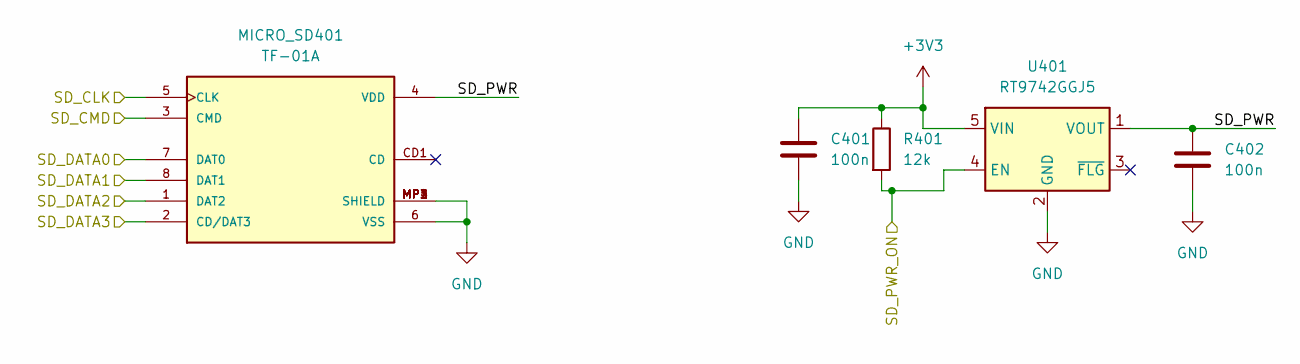
[picture p19: schematic micro_sd.kicad_sch, MicroSD Slot for CM4 (just for debugging!)]

Parts:
C401, C402: 100n; C_0805_2012Metric; LCSC C28233
MICRO_SD401: TF-01A; LCSC C91145
R401: 12k; R_0805_2012Metric; LCSC C17444
U401: RT9742GGJ5; TSOT-23-5; LCSC C250547

Connections:
+3V3: C401.1, R401.1, U401.5 (VIN); also elsewhere on the board
/CM4-Board/SD_CLK: MICRO_SD401.5 (CLK); also elsewhere on the board
/CM4-Board/SD_CMD: MICRO_SD401.3 (CMD); also elsewhere on the board
/CM4-Board/SD_DATA0: MICRO_SD401.7 (DAT0); also elsewhere on the board
/CM4-Board/SD_DATA1: MICRO_SD401.8 (DAT1); also elsewhere on the board
/CM4-Board/SD_DATA2: MICRO_SD401.1 (DAT2); also elsewhere on the board
/CM4-Board/SD_DATA3: MICRO_SD401.2 (CD/DAT3); also elsewhere on the board
/CM4-Board/SD_PWR_ON: R401.2, U401.4 (EN); also elsewhere on the board
/MicroSD/SD_PWR: C402.1, MICRO_SD401.4 (VDD), U401.1 (VOUT)
GND: C401.2, C402.2, MICRO_SD401.6 (VSS), MICRO_SD401.MP1 (SHIELD), MICRO_SD401.MP2 (SHIELD), MICRO_SD401.MP3 (SHIELD), MICRO_SD401.MP4 (SHIELD), U401.2 (GND); also elsewhere on the board

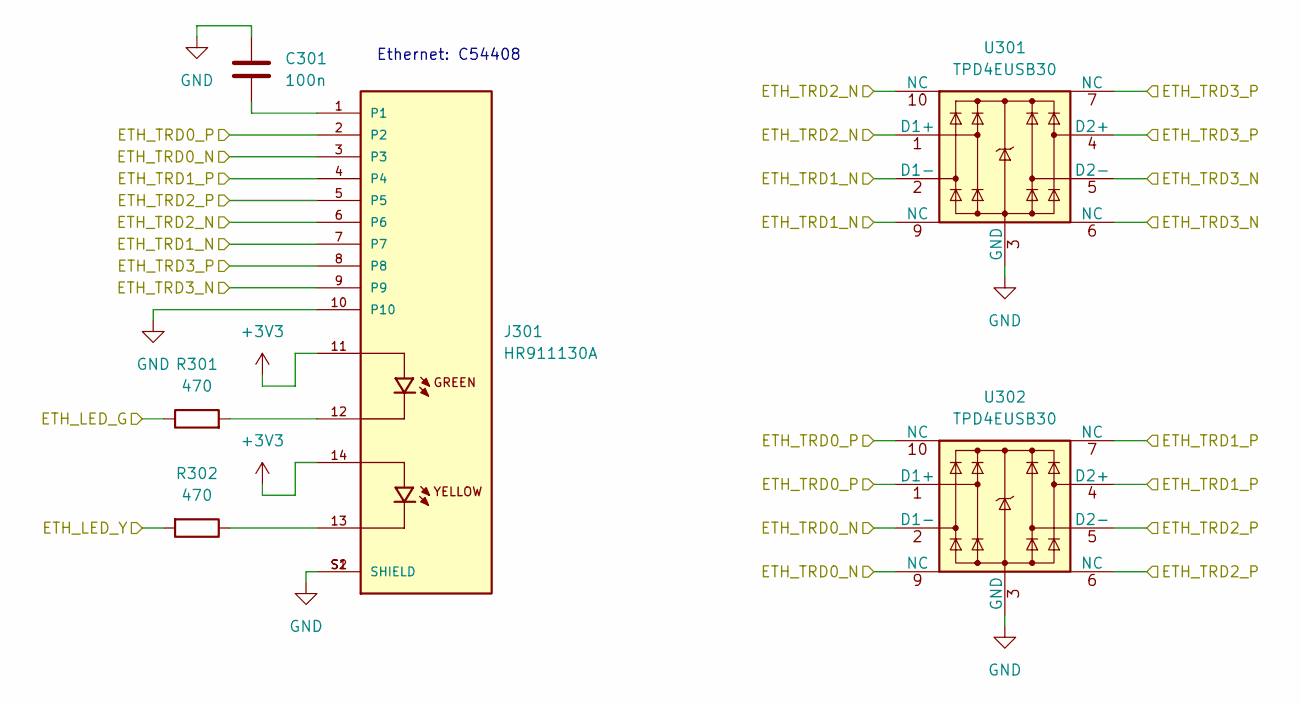
[picture p20: schematic ethernet.kicad_sch, Ethernet Port for CM4]

Parts:
C301: 100n; C_0805_2012Metric; LCSC C28233
J301: HR911130A; HANRUN_HR911130A; PARTREV A; LCSC C54408
R301, R302: 470; R_0805_2012Metric; LCSC C17710
U301, U302: TPD4EUSB30; USON-10_2.5x1.0mm_P0.5mm; LCSC C90627

Connections:
+3V3: J301.11, J301.14; also elsewhere on the board
/CM4-Board/ETH_LED_G: R301.1; also elsewhere on the board
/CM4-Board/ETH_LED_Y: R302.2; also elsewhere on the board
/CM4-Board/ETH_TRD0_N: J301.3, U302.2 (D1-), U302.9 (NC); also elsewhere on the board
/CM4-Board/ETH_TRD0_P: J301.2, U302.1 (D1+), U302.10 (NC); also elsewhere on the board
/CM4-Board/ETH_TRD1_N: J301.7, U301.2 (D1-), U301.9 (NC); also elsewhere on the board
/CM4-Board/ETH_TRD1_P: J301.4, U302.4 (D2+), U302.7 (NC); also elsewhere on the board
/CM4-Board/ETH_TRD2_N: J301.6, U301.1 (D1+), U301.10 (NC); also elsewhere on the board
/CM4-Board/ETH_TRD2_P: J301.5, U302.5 (D2-), U302.6 (NC); also elsewhere on the board
/CM4-Board/ETH_TRD3_N: J301.9, U301.5 (D2-), U301.6 (NC); also elsewhere on the board
/CM4-Board/ETH_TRD3_P: J301.8, U301.4 (D2+), U301.7 (NC); also elsewhere on the board
GND: C301.1, J301.10, J301.S1 (SHIELD), J301.S2 (SHIELD), U301.3 (GND), U301.8 (GND), U302.3 (GND), U302.8 (GND); also elsewhere on the board
unnamed: C301.2, J301.1
unnamed: J301.12, R301.2
unnamed: J301.13, R302.1

Notes on the sheet:
Ethernet: C54408

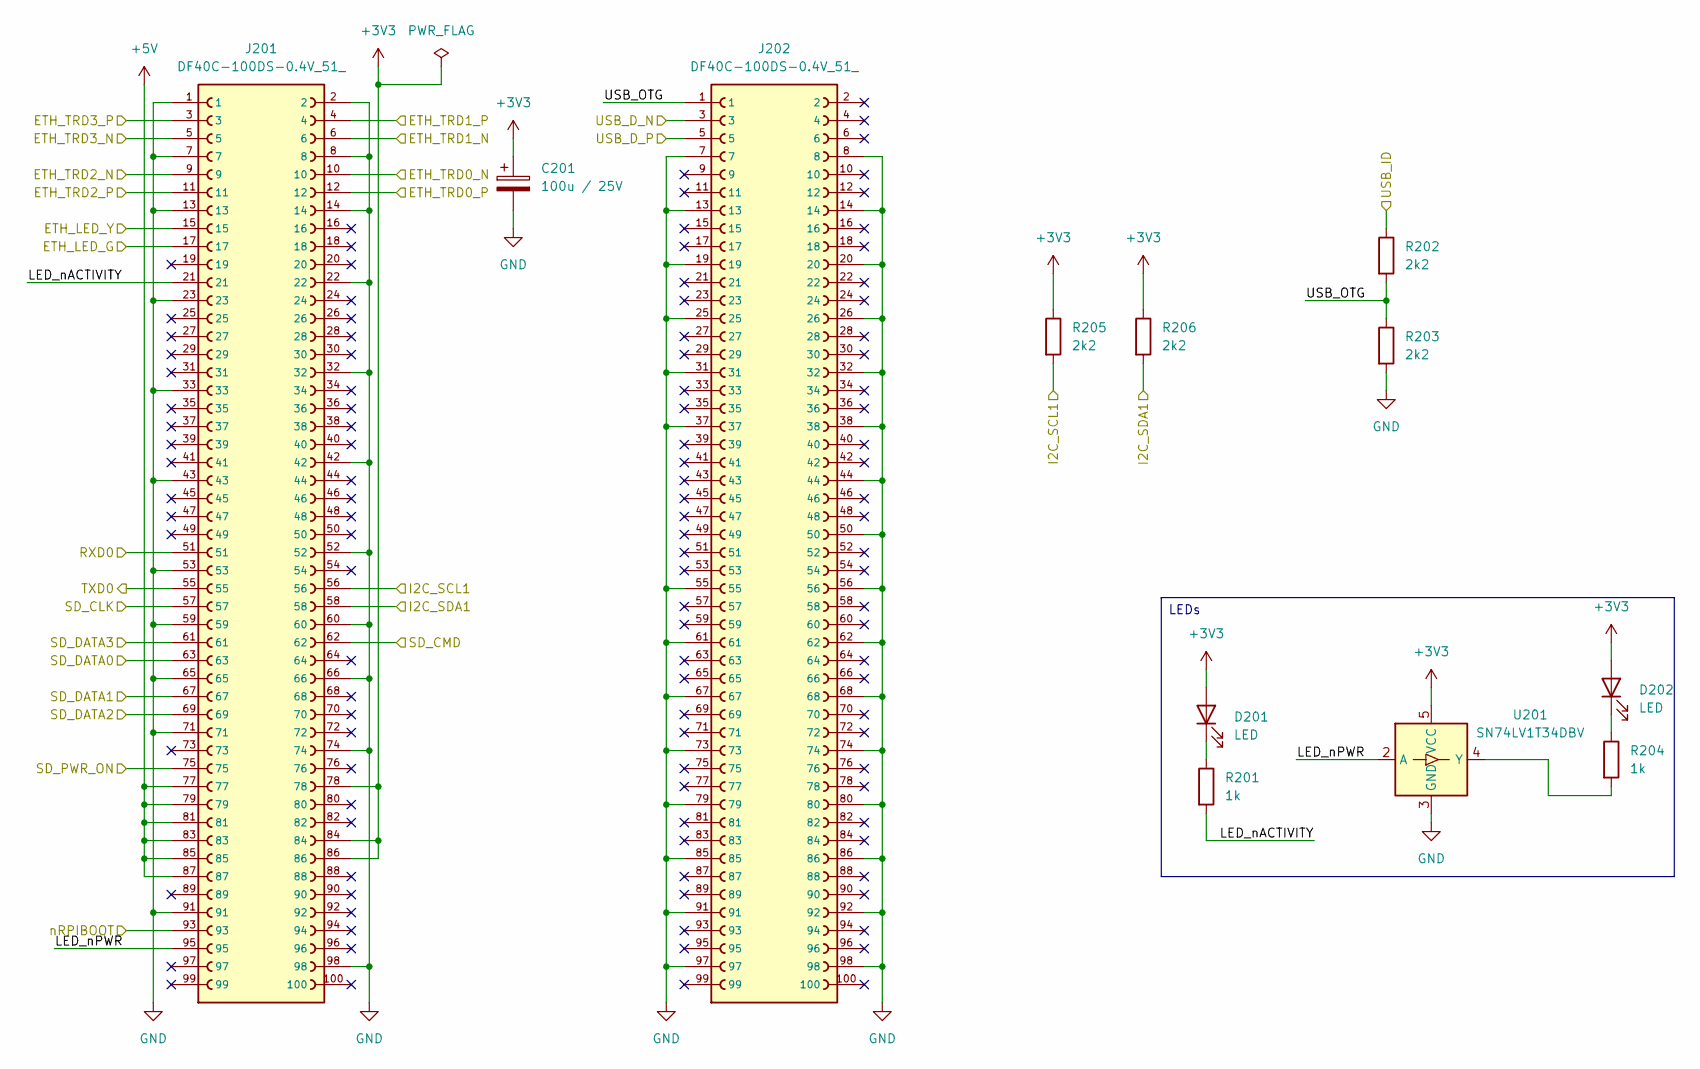
[picture p21: schematic cm4-board.kicad_sch, CM4 Board]

Parts:
C201: 100u / 25V; CP_EIA-7343-43_Kemet-X; LCSC C132558
D201, D202: LED; LED_0805_2012Metric; LCSC C84256
J201, J202: DF40C-100DS-0.4V_51_; HIROSE_DF40C-100DS-0.4V_51_; PARTREV Oct.1.2023; LCSC C597931
R201, R204: 1k; R_0805_2012Metric; LCSC C17513
R202, R203, R205, R206: 2k2; R_0805_2012Metric; LCSC C17520
U201: SN74LV1T34DBV; SOT-23-5; LCSC C100024

Connections:
+3V3: C201.1, D201.2 (A), D202.2 (A), J201.78, J201.84, J201.86, R205.1, R206.1, U201.5 (VCC); also elsewhere on the board
+5V: J201.77, J201.79, J201.81, J201.83, J201.85, J201.87; also elsewhere on the board
/CM4-Board/ETH_LED_G: J201.17; also elsewhere on the board
/CM4-Board/ETH_LED_Y: J201.15; also elsewhere on the board
/CM4-Board/ETH_TRD0_N: J201.10; also elsewhere on the board
/CM4-Board/ETH_TRD0_P: J201.12; also elsewhere on the board
/CM4-Board/ETH_TRD1_N: J201.6; also elsewhere on the board
/CM4-Board/ETH_TRD1_P: J201.4; also elsewhere on the board
/CM4-Board/ETH_TRD2_N: J201.9; also elsewhere on the board
/CM4-Board/ETH_TRD2_P: J201.11; also elsewhere on the board
/CM4-Board/ETH_TRD3_N: J201.5; also elsewhere on the board
/CM4-Board/ETH_TRD3_P: J201.3; also elsewhere on the board
/CM4-Board/LED_nACTIVITY: J201.21, R201.2
/CM4-Board/LED_nPWR: J201.95, U201.2 (A)
/CM4-Board/RXD0: J201.51; also elsewhere on the board
/CM4-Board/SD_CLK: J201.57; also elsewhere on the board
/CM4-Board/SD_CMD: J201.62; also elsewhere on the board
/CM4-Board/SD_DATA0: J201.63; also elsewhere on the board
/CM4-Board/SD_DATA1: J201.67; also elsewhere on the board
/CM4-Board/SD_DATA2: J201.69; also elsewhere on the board
/CM4-Board/SD_DATA3: J201.61; also elsewhere on the board
/CM4-Board/SD_PWR_ON: J201.75; also elsewhere on the board
/CM4-Board/TXD0: J201.55; also elsewhere on the board
/CM4-Board/USB_OTG: J202.1, R202.2, R203.1
/I2C_SCL1: J201.56, R205.2; also elsewhere on the board
/I2C_SDA1: J201.58, R206.2; also elsewhere on the board
/USB_D_N: J202.3; also elsewhere on the board
/USB_D_P: J202.5; also elsewhere on the board
/USB_ID: R202.1; also elsewhere on the board
/nRPIBOOT: J201.93; also elsewhere on the board
GND: C201.2, J201.1, J201.2, J201.7, J201.8, J201.13, J201.14, J201.22, J201.23, J201.32, J201.33, J201.42, J201.43, J201.52, J201.53, J201.59, J201.60, J201.65, J201.66, J201.71, J201.74, J201.91, J201.98, J202.7, J202.8, J202.13, J202.14, J202.19, J202.20, J202.25, J202.26, J202.31, J202.32, J202.37, J202.38, J202.44, J202.50, J202.55, J202.56, J202.61, J202.62, J202.67, J202.68, J202.73, J202.74, J202.79, J202.80, J202.85, J202.86, J202.91, J202.92, J202.97, J202.98, R203.2, U201.3 (GND); also elsewhere on the board
unnamed: D201.1 (K), R201.1
unnamed: D202.1 (K), R204.1
unnamed: R204.2, U201.4 (Y)

Notes on the sheet:
LEDs

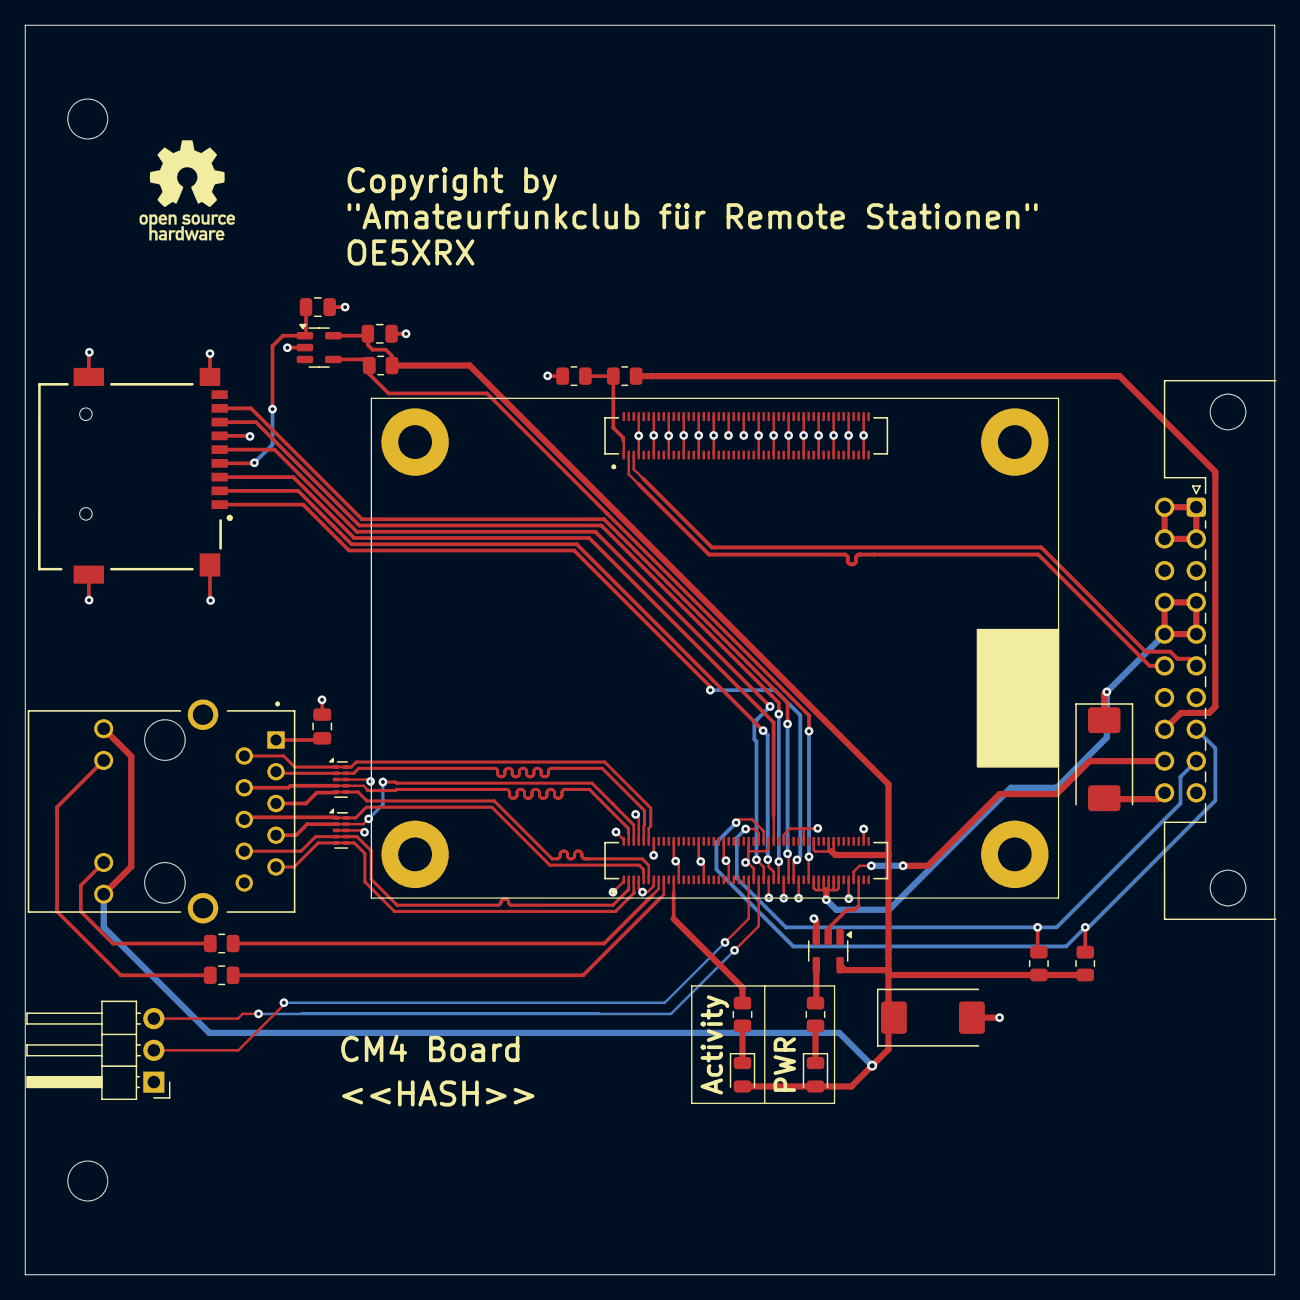
[picture p22: board cm4.kicad_pcb from above]

Board: 4 copper layers, 100.0 x 100.0 mm, 28 parts (0 on the bottom side), 39 nets.
