OE5XRX/RemoteStation/pcb/power/power.kicad_pcb

## KiCad design pcb/power/power.kicad_pcb (2025-05-24)

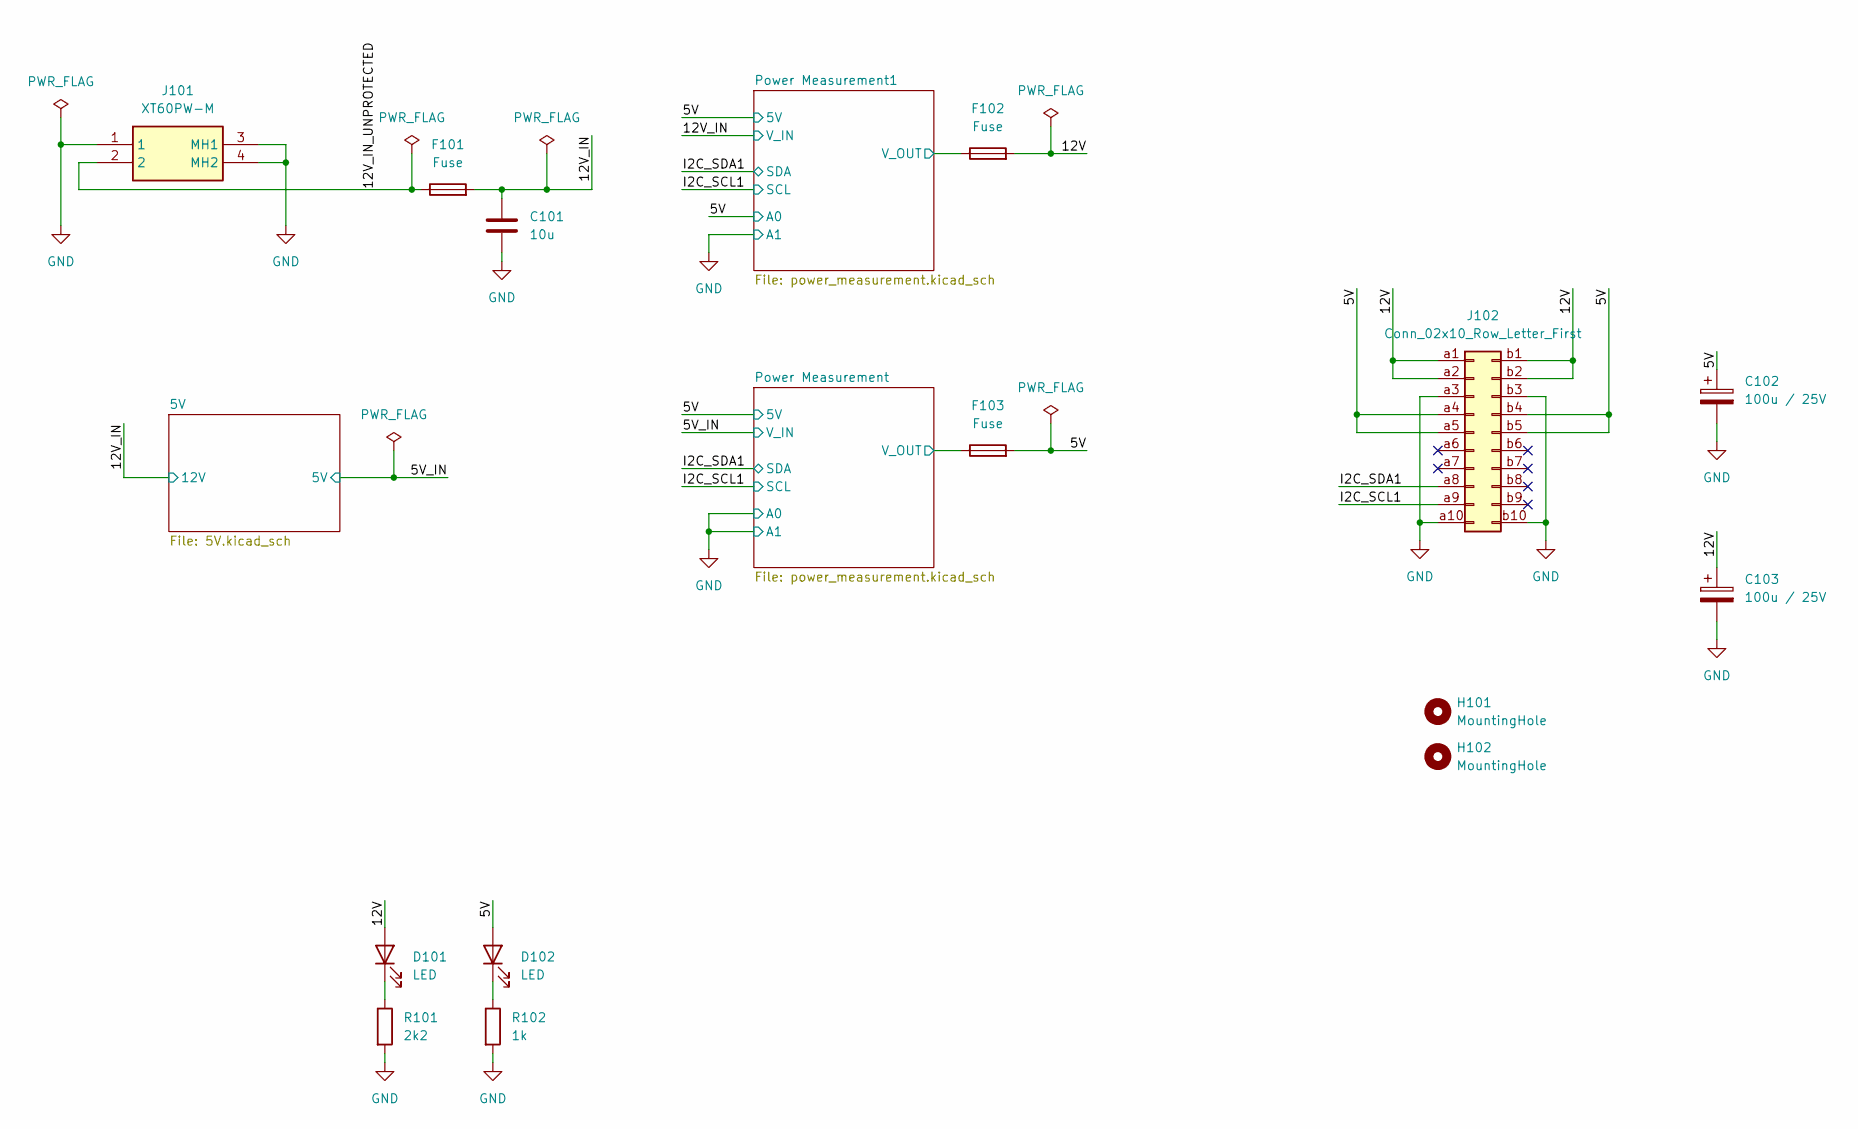
[picture p23: schematic power.kicad_sch]

Parts:
C101: 10u; C_1206_3216Metric; LCSC C13585
C102, C103: 100u / 25V; CP_EIA-7343-43_Kemet-X; LCSC C132558
D101, D102: LED; LED_0805_2012Metric; LCSC C84256
F101, F102, F103: Fuse; FUSE_01530007Z; MOUSER 576-01530007Z
H101, H102: MountingHole; MountingHole_3.2mm_M3
J101: XT60PW-M; XT60PWM
J102: Conn_02x10_Row_Letter_First; PCN10C-20S-2.54DS; MOUSER 798-PCN10C20S254DS72
R101: 2k2; R_0805_2012Metric; LCSC C17520
R102: 1k; R_0805_2012Metric; LCSC C17513

Connections:
/5V: C102.1, D102.2 (A), F103.2, J102.a4, J102.a5, J102.b4, J102.b5; also elsewhere on the board
/12V: C103.1, D101.2 (A), F102.2, J102.a1, J102.a2, J102.b1, J102.b2
/12V_IN: C101.1, F101.2; also elsewhere on the board
/12V_IN_UNPROTECTED: F101.1, J101.2
/I2C_SCL1: J102.a9; also elsewhere on the board
/I2C_SDA1: J102.a8; also elsewhere on the board
/Power Measurement1/V_OUT: F102.1; also elsewhere on the board
/Power Measurement/V_OUT: F103.1; also elsewhere on the board
GND: C101.2, C102.2, C103.2, J101.1, J101.3 (MH1), J101.4 (MH2), J102.a3, J102.a10, J102.b3, J102.b10, R101.2, R102.2; also elsewhere on the board
unnamed: D101.1 (K), R101.1
unnamed: D102.1 (K), R102.1

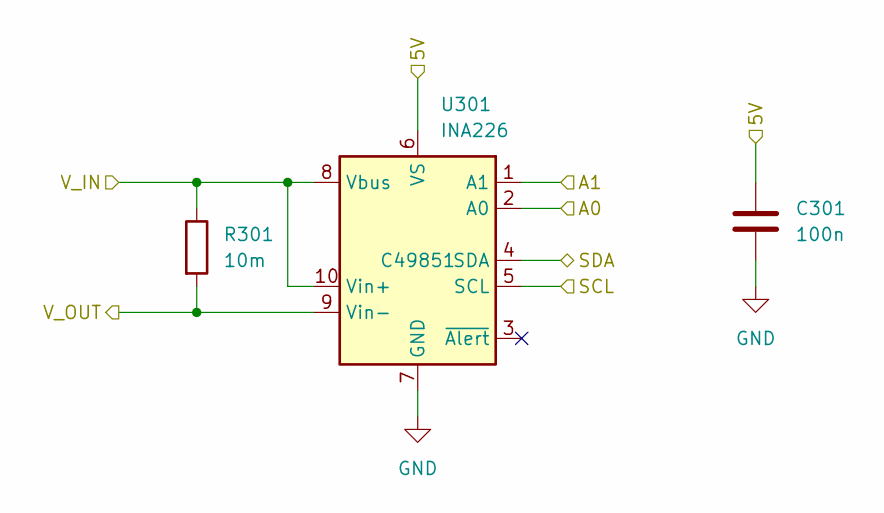
[picture p24: schematic power_measurement.kicad_sch]

Parts:
C301: 100n; C_0805_2012Metric; LCSC C28233
R301: 10m; R_2512_6332Metric; MOUSER 652-CRF2512FZR010ELF
U301: INA226; VSSOP-10_3x3mm_P0.5mm; LCSC C49851

Connections:
/5V: C301.1, U301.6 (VS); also elsewhere on the board
/5V_IN: R301.1, U301.8 (Vbus), U301.10 (Vin+); also elsewhere on the board
/I2C_SCL1: U301.5 (SCL); also elsewhere on the board
/I2C_SDA1: U301.4 (SDA); also elsewhere on the board
/Power Measurement/V_OUT: R301.2, U301.9 (Vin-); also elsewhere on the board
GND: C301.2, U301.1 (A1), U301.2 (A0), U301.7 (GND); also elsewhere on the board

Parts of its further copies:
C401: 100n; C_0805_2012Metric; LCSC C28233
R401: 10m; R_2512_6332Metric; MOUSER 652-CRF2512FZR010ELF
U401: INA226; VSSOP-10_3x3mm_P0.5mm; LCSC C49851

Connections of its further copies:
/5V: C401.1, U401.2 (A0), U401.6 (VS); also elsewhere on the board
/12V_IN: R401.1, U401.8 (Vbus), U401.10 (Vin+); also elsewhere on the board
/I2C_SCL1: U401.5 (SCL); also elsewhere on the board
/I2C_SDA1: U401.4 (SDA); also elsewhere on the board
/Power Measurement1/V_OUT: R401.2, U401.9 (Vin-); also elsewhere on the board
GND: C401.2, U401.1 (A1), U401.7 (GND); also elsewhere on the board

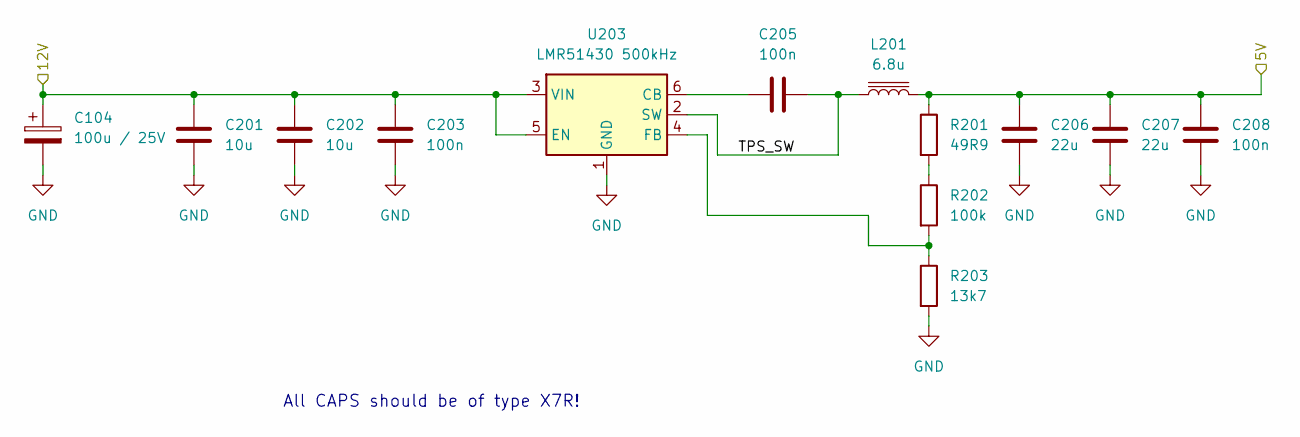
[picture p25: schematic 5V.kicad_sch]

Parts:
C104: 100u / 25V; CP_EIA-7343-43_Kemet-X; LCSC C132558
C201, C202: 10u; C_1206_3216Metric; LCSC C13585
C203, C205, C208: 100n; C_0805_2012Metric; LCSC C28233
C206, C207: 22u; C_1206_3216Metric; LCSC C12891
L201: 6.8u; WE-XHMI_6060; MOUSER 710-74439346068
R201: 49R9; R_0805_2012Metric; MOUSER 667-ERA-6AED49R9V
R202: 100k; R_0805_2012Metric; MOUSER 603-RC0805JR-07100KL
R203: 13k7; R_0805_2012Metric; MOUSER 652-CR0805FX-1372ELF
U203: LMR51430 500kHz; SOT-23-6; MOUSER 595-LMR51430XDDCR

Connections:
/5V/TPS_SW: C205.2, L201.1, U203.2 (SW)
/5V_IN: C206.2, C207.2, C208.2, L201.2, R201.1; also elsewhere on the board
/12V_IN: C104.1, C201.1, C202.1, C203.1, U203.3 (VIN), U203.5 (EN); also elsewhere on the board
GND: C104.2, C201.2, C202.2, C203.2, C206.1, C207.1, C208.1, R203.2, U203.1 (GND); also elsewhere on the board
unnamed: R201.2, R202.1
unnamed: C205.1, U203.6 (CB)
unnamed: R202.2, R203.1, U203.4 (FB)

Notes on the sheet:
All CAPS should be of type X7R!
