OE5XRX/RemoteStation/pcb/power/power.kicad_pcb

## KiCad design pcb/power/power.kicad_pcb (continued)

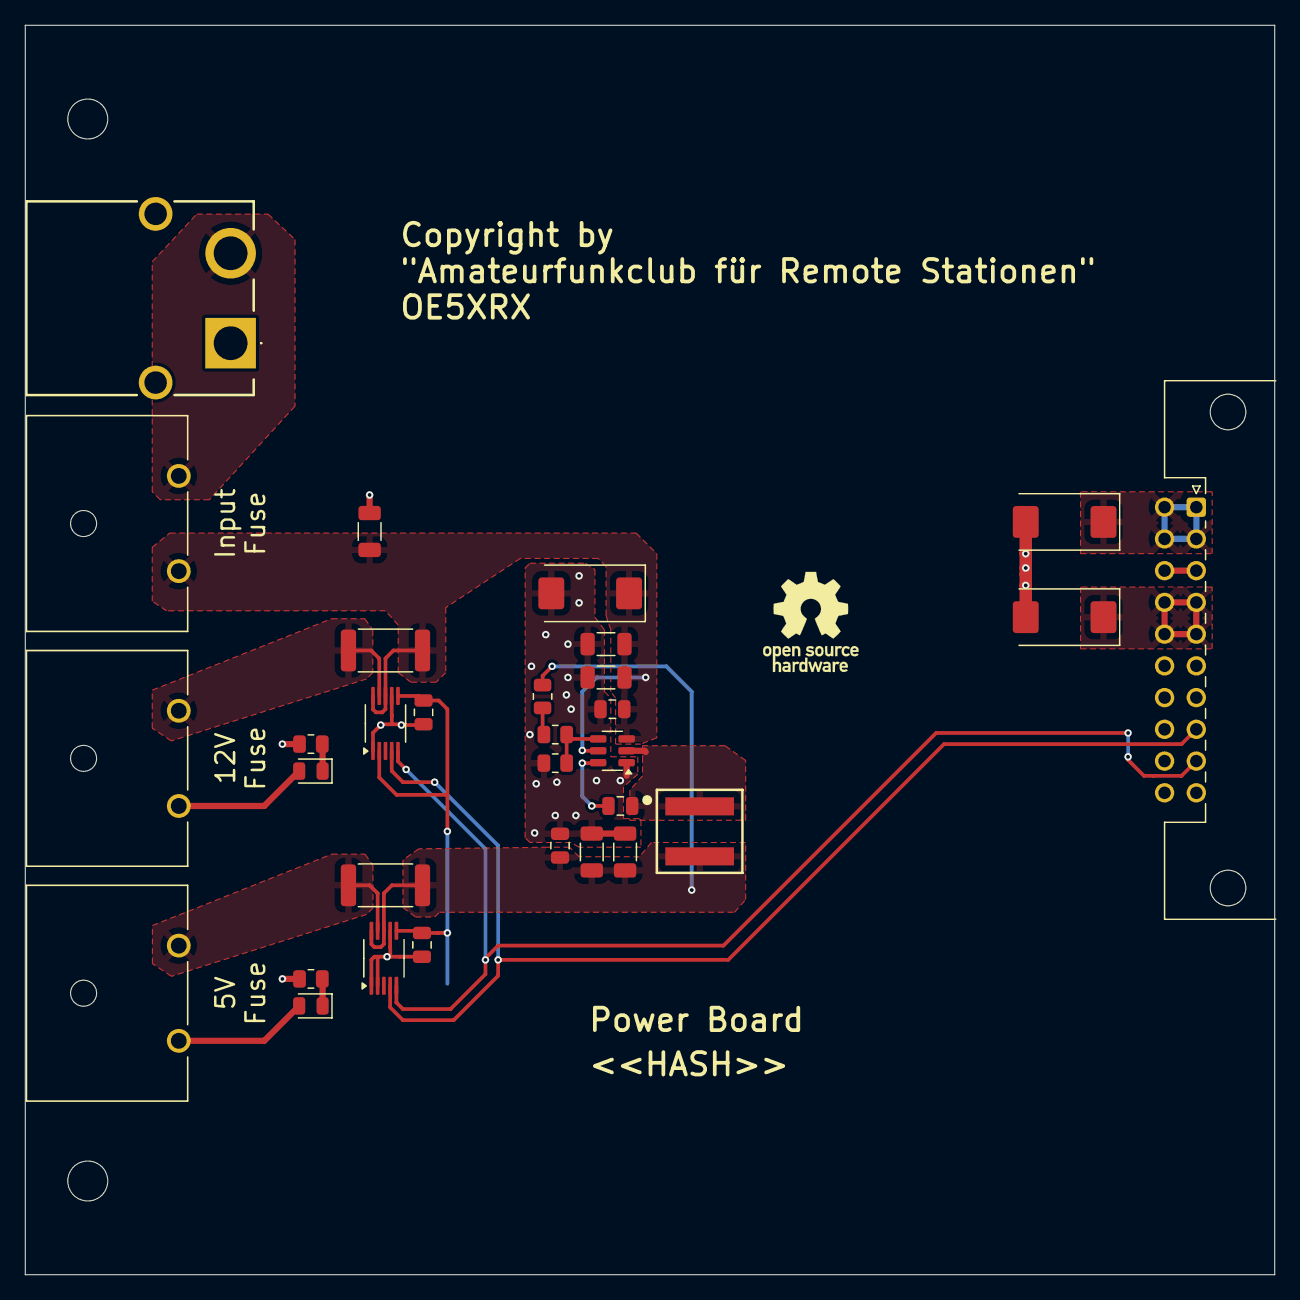
[picture p26: board power.kicad_pcb from above]

Board: 4 copper layers, 100.0 x 100.0 mm, 33 parts (0 on the bottom side), 16 nets.
