OE5XRX/RemoteStation/(commit log)

2024-12-14 setup first pcb stuff
    [RemoteStation.kicad_pcb, RemoteStation.kicad_sch, bus.kicad_sch, raspberry_pi.kicad_sch, vhf.kicad_sch]
2024-12-15 update scripts
    [RemoteStation.kicad_sch, bus.kicad_sch]
2024-12-18 big update
    [RemoteStation.kicad_sch, bus.kicad_sch, raspberry_pi.kicad_sch, vhf.kicad_sch]
2024-12-20 add hash
    [RemoteStation.kicad_sch]
2024-12-20 add hash and title
    [RemoteStation.kicad_sch, bus.kicad_sch, raspberry_pi.kicad_sch]
2024-12-22 update connectors
    [RemoteStation.kicad_sch, raspberry_pi.kicad_sch]
2024-12-22 remove not connected no_connect
    [RemoteStation.kicad_sch]
2024-12-22 split in multiple projects
    [RemoteStation.kicad_pcb, RemoteStation.kicad_sch, bus.kicad_sch, connector.kicad_sch, power.kicad_sch, raspberry_pi.kicad_sch]
2024-12-22 add pcb file again
    [bus.kicad_pcb]
2024-12-22 add pcb dimension
    [bus.kicad_pcb]
2024-12-22 add symlink
    [bus.kicad_sch, connector.kicad_sch]
2024-12-22 update cm4
    [RemoteStation.kicad_sch, cm4-board.kicad_sch, cm4-io.kicad_sch, cm4.kicad_pcb, cm4.kicad_sch, connector.kicad_sch, raspberry_pi.kicad_sch]
2024-12-25 update cm4 board
    [cm4-board.kicad_sch, cm4-io.kicad_sch, cm4.kicad_sch]
2024-12-25 fix power pin issue
    [cm4.kicad_sch]
2024-12-25 add device tester
    [device_test.kicad_pcb, device_test.kicad_sch, power.kicad_sch]
2024-12-26 add leds to device tester
    [device_test.kicad_sch]
2024-12-26 add leds
    [power.kicad_sch]
2024-12-26 update annotate
    [device_test.kicad_sch]
2024-12-26 update pcb limits and add other pcb setup
    [bus.kicad_pcb, cm4.kicad_pcb, device_test.kicad_pcb]
2024-12-27 update footprints
2024-12-27 add footprints
    [device_test.kicad_sch]
2024-12-31 pcb update
    [device_test.kicad_pcb, device_test.kicad_sch]
2024-12-31 add logo
    [device_test.kicad_pcb, device_test.kicad_sch]
2025-01-08 ignore hole_clearance
2025-01-08 remove usb a, add usb c
    [bus_tester_connector.kicad_sch, device_test.kicad_pcb, device_tester_connector.kicad_sch]
2025-01-08 add correct HASH tag to pcb
    [device_test.kicad_pcb]
2025-01-09 update LCSC codes
    [bus_tester_connector.kicad_sch, device_test.kicad_sch, device_tester_connector.kicad_sch]
2025-01-25 added more information on PCB
    [device_test.kicad_pcb]
2025-01-25 update pcb
    [cm4-board.kicad_sch, cm4.kicad_pcb, cm4.kicad_sch, device_test.kicad_pcb, ethernet.kicad_sch, micro_sd.kicad_sch]
2025-01-25 update parts
    [cm4-board.kicad_sch]
2025-01-25 add correct mounting holes
    [cm4.kicad_pcb]
2025-01-25 fix mounting holes
    [cm4.kicad_pcb]
2025-01-26 update fields
    [device_test.kicad_pcb]
2025-02-11 update device test pcb
    [bus_tester_connector.kicad_sch, device_test.kicad_pcb, device_tester_connector.kicad_sch]
2025-02-12 upgrade to kicad 8.0.8
    [device_test.kicad_pcb]
2025-02-14 update footprints and step's
    [bus_tester_connector.kicad_sch, device_test.kicad_pcb, device_tester_connector.kicad_sch]
2025-02-14 add missing 3d model
    [device_test.kicad_pcb]
2025-02-15 update footprint
2025-02-15 update footprint and fix DRC
    [device_test.kicad_pcb]
2025-02-15 update footprint lib name & change connector footprint
    [bus_tester_connector.kicad_sch, device_test.kicad_pcb, device_tester_connector.kicad_sch]
2025-02-15 cm4: update footprint library, add 3d files, update dimensions
    [cm4-board.kicad_sch, cm4.kicad_pcb, cm4.kicad_sch, ethernet.kicad_sch, micro_sd.kicad_sch]
2025-02-15 fix power pins
    [cm4.kicad_sch]
2025-02-16 finish all routing
    [cm4.kicad_pcb]
2025-02-16 update diff pairs
    [cm4.kicad_pcb]
2025-02-18 fix diff pairs
    [cm4.kicad_pcb]
2025-02-18 fix pin assignment
    [cm4.kicad_pcb, cm4.kicad_sch, device_test.kicad_pcb, device_tester_connector.kicad_sch]
2025-02-25 add i2c
    [cm4-board.kicad_sch, cm4.kicad_pcb, cm4.kicad_sch, micro_sd.kicad_sch]
2025-02-25 fix DRC
    [device_test.kicad_pcb]
2025-03-02 add more info data
    [cm4.kicad_pcb, device_test.kicad_pcb]
2025-03-02 add caps
    [bus_tester_connector.kicad_sch, device_test.kicad_pcb, device_test.kicad_sch, device_tester_connector.kicad_sch]
2025-03-02 add more caps
    [cm4-board.kicad_sch, cm4.kicad_pcb, cm4.kicad_sch]
2025-03-02 update lscs fields
    [cm4-board.kicad_sch, cm4.kicad_pcb, ethernet.kicad_sch, micro_sd.kicad_sch]
2025-03-06 re-rout some routes
    [cm4.kicad_pcb]
2025-03-09 update bus schematic
    [bus.kicad_sch, connector.kicad_sch, power.kicad_sch]
2025-03-09 update bus
    [bus.kicad_sch, rpi.kicad_sch]
2025-03-09 remove not used file
    [power.kicad_sch]
2025-03-09 add new footprints
2025-03-09 update bus pcb
    [bus.kicad_pcb, bus.kicad_sch, device_connector.kicad_sch, power_connector.kicad_sch]
2025-03-09 power pin fix
    [power_connector.kicad_sch]
2025-03-17 update pcb size
    [bus.kicad_pcb, bus.kicad_sch, cm4.kicad_pcb, cm4.kicad_sch, device_connector.kicad_sch, power_connector.kicad_sch, rpi.kicad_sch]
2025-03-17 upgrade to kicad 9.0.0
    [bus.kicad_pcb, bus.kicad_sch, bus_tester_connector.kicad_sch, cm4-board.kicad_sch, cm4.kicad_pcb, cm4.kicad_sch, device_connector.kicad_sch, device_test.kicad_pcb]
2025-03-17 upgrade kibot to kicad 9
2025-03-17 fix unconnected
    [bus.kicad_pcb]
2025-03-17 update symbol
    [cm4-board.kicad_sch]
2025-03-22 update hole size
    [bus.kicad_pcb, bus.kicad_sch]
2025-03-23 change mounting hole
    [device_test.kicad_pcb, device_test.kicad_sch]
2025-03-23 some updates
    [cm4.kicad_pcb]
2025-03-28 add power pcb
    [5V.kicad_sch, power.kicad_pcb, power.kicad_sch, power_data.kicad_sch, power_measurement.kicad_sch]
2025-03-28 add power pcb doku
2025-04-02 routing update
    [power.kicad_pcb]
2025-04-04 update ALL parts
    [5V.kicad_sch, bus.kicad_pcb, bus.kicad_sch, bus_tester_connector.kicad_sch, cm4-board.kicad_sch, cm4.kicad_pcb, cm4.kicad_sch, device_connector.kicad_sch]
2025-04-04 update XT30 to XT60 connector
    [power.kicad_pcb, power.kicad_sch]
2025-04-04 remove XT30 connector
2025-04-04 update XT60 connector to official one
    [power.kicad_pcb, power.kicad_sch]
2025-04-04 create more space for 3d printed parts
    [bus.kicad_pcb]
2025-04-06 remove project path of 3D model
    [bus.kicad_pcb]
2025-04-06 revert changes
    [bus.kicad_pcb]
2025-04-08 fix issues
    [bus.kicad_pcb]
2025-04-09 move smd parts to backside - no usb length improvements
    [bus.kicad_pcb, bus.kicad_sch, rpi.kicad_sch]
2025-04-10 fix diff pair
    [bus.kicad_pcb, rpi.kicad_sch]
2025-04-21 move kibot config files to pcb folder
2025-05-20 power: enable pin NICHT auf GND
2025-05-20 fix power, pin 2
    [5V.kicad_sch, power.kicad_pcb]
2025-05-24 update power pcb
    [5V.kicad_sch, power.kicad_pcb, power.kicad_sch, power_measurement.kicad_sch]
2025-05-24 update fields and mouser components
    [5V.kicad_sch, power.kicad_pcb, power.kicad_sch, power_measurement.kicad_sch]
2025-05-24 fix footprint in bus pcb
    [bus.kicad_pcb, device_connector.kicad_sch, rpi.kicad_sch]
2025-05-25 rename differential nets correctly and fix cm4 footprint
    [cm4-board.kicad_sch, cm4.kicad_pcb, cm4.kicad_sch, ethernet.kicad_sch]
2025-05-25 cm4: add debug uart
    [cm4-board.kicad_sch, cm4.kicad_pcb, cm4.kicad_sch]
2025-05-25 fix device tester pcb
    [bus_tester_connector.kicad_sch, device_test.kicad_pcb, device_tester_connector.kicad_sch]
2025-06-22 add fm pcb
    [connector_cpu.kicad_sch, fm.kicad_pcb, fm.kicad_sch]
2025-06-23 update fm pcb
    [connector_cpu.kicad_sch, fm.kicad_pcb, fm.kicad_sch]
2025-06-24 add title block to fm module
    [connector_cpu.kicad_sch, fm.kicad_pcb, fm.kicad_sch]
2025-06-29 update fm module
    [AF_OUT-ADC-filter.kicad_sch, DAC-MIC_IN-filter.kicad_sch, connector_cpu.kicad_sch, fm.kicad_pcb, fm.kicad_sch, pin_driver.kicad_sch]
2025-07-01 update bus: plotinvisibletext
    [bus.kicad_pcb]
2025-07-02 change segment in fm pcb
    [fm.kicad_pcb]
2025-07-04 multiple fixes
    [fm.kicad_pcb, fm.kicad_sch]
2025-07-05 fix multiple inventree parts
    [fm.kicad_pcb, fm.kicad_sch]
