OE5XRX/RemoteStation/(notices)

Notices in the files:
pcb/power/power.kicad_pcb:
Copyright by
{dblquote}Amateurfunkclub für Remote Stationen{dblquote}
